co61/Mecanique_Vibratoire/Commande-Acquisition/Tache 2 _ STM32/STM32F411RE.png

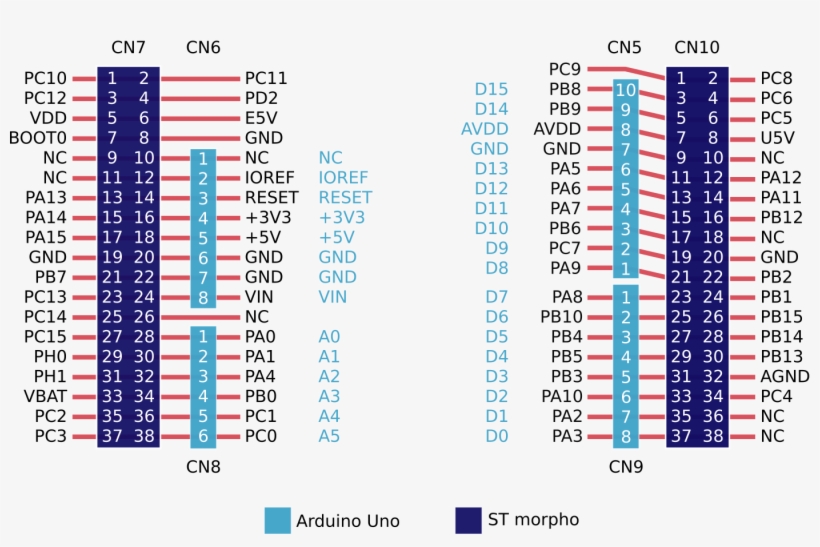
Commande-Acquisition/Tache 2 _ STM32/STM32F411RE.png
