co61/Mecanique_Vibratoire/README.md

# Mecanique_Vibratoire
Conception d'un banc de mesure de flexion sur une lame 
Merci de parcourir les différents dossier pour y découvrir les Rapports asociés
