co61/Mecanique_Vibratoire/Mécanique/Tache 5 _ 6 _ CAO/README.txt

~~~~~~~~~~~~~~~~~~~~~~~~~~~~~ Fichiers Catia : ~~~~~~~~~~~~~~~~~~~~~~~~~~~~

Pour observer la CAO globale : Assemblage "finale.CATProduct"

Dossier "Pupitre sécu V2" : ouvrir "pupitre.CATProduct" et
ensemble "alim.CATProduct".

Dossier "Bloc relais" : contient les fichiers modélisant le relais,
le rail DIN et les blocs de jonction.

Dossier "Electroaimant" : contient les fichiers modélisant l'électroaimant
et son support. La version utilisée dans l'assemblage est la V2.

Dossier "Mise en plan" : contient les .CATDrawing, les pdf, la nomenclature
et le dossier de fabrication

Fichier "lame &fixe.CATProduct" : assemble de la transmission (cadre et
fixation de la lame)

REMARQUE : après tests de fichiers sur plusieurs ordinateurs, certains PC
modifient les noms de fichiers, et l'assemblage ne retrouvent plus les 
fichiers. Tout a été fait pour limiter le risque. Cependant, pour les deux
boutons poussoirs, l'assemblage ne retrouve pas les deux fichiers. Ils se 
situent dans le dossier "pupitre sécu V2" puis les dossiers correspondants
aux boutons.
