co61/Mecanique_Vibratoire/Commande-Acquisition/Tâche 3 _ Intégration élec/composants électroniques/Commande de composants.docx

Liste des composants à commander

Projet CMV - groupe 4

Corentin Esnault

Désignation | code commande RS | Ref fabricant | marque | lien
Bouton-poussoir, Momentané, 2 A, 24 V c.c., Blanc, Montage panneau | 119-2908 | 1212C WHITE | APEM | https://fr.rs-online.com/web/p/boutons-poussoirs/1192908/
électro-aimant linéaire Mecalectro 12 V c.c., course 6mm, force 1N 27 x 22 x 20 mm (modèle poussant, avec ressort de rappel) | 307-3382 | 8.M11 AA 62 12 VCC 100% | Mécalectro | https://fr.rs-online.com/web/p/electroaimants-lineaires/3073382
Cartouche fusible RS PRO, 5A, 5 x 20mm, Type T, 250V c.a. | 563-693 | | RS PRO | https://fr.rs-online.com/web/p/fusibles-cartouches/0563693
Porte-fusible monté sur circuit 10A pour 5 x 20mm, fusible Cartouche 250V c.a. | 176-9047 | 0031.8201 | Schurter | https://fr.rs-online.com/web/p/porte-fusible-pour-ci/1769047

Pourquoi cet électro-aimant :

Dans le cadre de notre projet, afin de contrôler la position du réglet avant l’oscillation libre, nous souhaitons acquérir un électro-aimant solénoïde de type push. L’électro-aimant doit tenir sur la structure et doit avoir une course suffisamment longue pour maintenir le réglet lorsque le piston est sorti tout en restant hors de sa portée lorsque le piston est rentré.

Nous avons choisie l’électro-aimant linéaire Mecalectro 12 V c.c., course 6mm, force 1N 27 x 22 x 20 mm (modèle poussant, avec ressort de rappel)

Code commande RS: 307-3382

Référence fabricant : 8.M11 AA 62 12 VCC 100%

Marque : Mecalectro

En effet, il est alimenté en 12V, la puissance de 30W autorisée par notre système lui est suffisante, ses dimensions (27 x 22 x 20mm) sont peu encombrantes et son châssis permet une fixation simple. Ensuite, sa course de 6mm est suffisante pour bloquer et libérer le réglet. Enfin, il est disponible en poussant (push) et possède un ressort de rappel, ainsi on l’alimente pour le sortir et on coupe l’alimentation pour le rentrer.

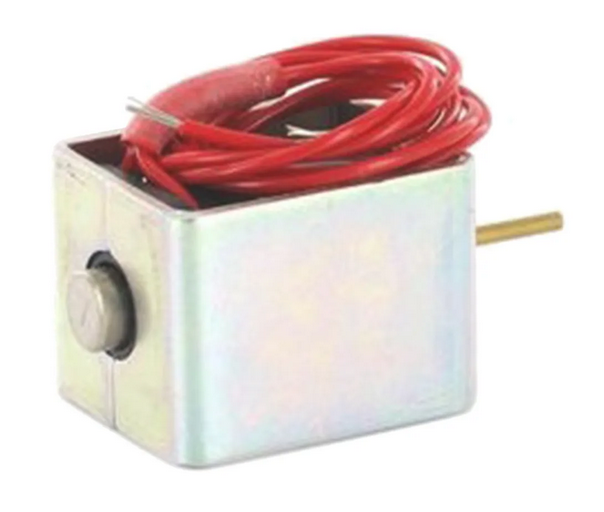
[picture p25: figure]
