co61/Mecanique_Vibratoire/Rapports d_activités PDF/Tache 1 Arduino - Google Docs.pdf

GROUPE N° 4
Tâche N° 1

Intégraon Arduino
Régné 100%

### 1. Etat initial de la tâche :

Au démarrage du semestre nous disposons de codes basiques réalisés l’année dernière. Les codes sont décomposés en deux pares, une pour le capteur accéléromètre, une autre pour la geson de l’asservissement du moteur. Les différents schémas de câblage sont disponibles Les codes devront être très largement améliorés et il sera nécessaire de découvrir une soluon pour rassembler le tout en une seule carte arduino. La vitesse de traitement maximale devra être mesurée.

### 2. Objectifs :

Objecf principal: Réaliser le code Arduino pour répondre aux besoins du projet en ulisant une seule carte Arduino.
- Compréhension et intégraon des codes pour retrouver le fonconnement de l’année précédente
- Amélioraon du code, opmisaon
- Intégraon du code capteur avec le code moteur pour ne garder qu'une carte (100%)
- Geson du port série, dans les deux sens de communicaon (20%)

### 3. Démarche de travail/plannification/problèmes rencontré

Problèmes rencontrés | Soluon supposée / apportée
Code arduino capteur ne correspond pas au capteur possédé, le capteur ulisé ne possède pas de tension de référence les schémas sont donc faux. Le comporte des mulples foncons inules qui ne font qu’alourdir le traitement. | neoyage du code et adaptaon au capteur ulisé cee année pour le groupe 4
Pas de communicaon avancée avec l’IHM pour la mise en place de paramètres spécifiques sur l’arduino, seulement la valeur de l’accéléromètre est transmise. | aente de l’avancement de l’IHM pour connaître les besoins
Code moteur fonconnel mais ne réalisant aucun asservissement, l’asservissement n’est pas fonconnel, la valeur de commande se bloque à la valeur maximale et ne change plus. | recherche de code d’asservissement existant, adaptaon au moteur ulisé, calcul des coefficients d’asservissement.
Deux cartes nécessaire pour le fonconnement actuel | Réflexion sur le nombre de mers et d'interrupons disponible, nombre d’entrée sore suffisantes
Problème de contrôle des Timer pour les différentes tâches | Ulisaon, configuraons à plus bas niveau des 3 mers pour l’ulisaon simultanée de l'accéléromètre et du moteur asservi en vitesse, ainsi que la communicaon temporelle avec le PC

Intégraon Arduino
Régné 100%

### 4. Présentation des résultats obtenus

Les débuts de la tâche d’intégraon du code Arduino ont été le neoyage du code, l’adaptaon du code au capteur ulisé pour l’année 2021 au sein du groupe 4. En effet, celui si ne possède pas de pin Vref et le code effectuait un appel trop complexe et inule de foncons pour une tâche aussi simple que la lecture d’un pin et l’envoie de cee donnée sur le port série. Nous avons dans un premier temps câblé le capteur sur la carte. Grâce aux fils rigides disponibles, la soluon de fils plus fin et sans gaine plasque (fils émaillés) est vite explorée et celui-ci arrivera avec la commande des composants électroniques. Le fil commandé (0.01mm) est beaucoup trop fin pour la réalisaon de soudure simple et correcte ainsi que pour une connuité opmale. Nous conseillons pour les années suivantes d’acheter plus épais tout en restant dans un diamètre qui permet une légèreté et une absence de rigidité : 0.1mm devrait être sasfaisant.
J’effectue ensuite l’affichage des données sous forme de graphiques pour une meilleure interprétaon des données lues. Cet affichage est généré grâce au traceur série délivré par arduino.
Je suis ensuite passé sur la compréhension du code de l’asservissement du moteur. Le code disponible ne possédait pas d’asservissement. Après de nombreuses recherches je me suis donc concentré sur l’ulisaon d’une librairie d’asservissement PID. Cee librairie m’a permis de correctement asservir le moteur, j’ai donc repris le code à parr de zéro.

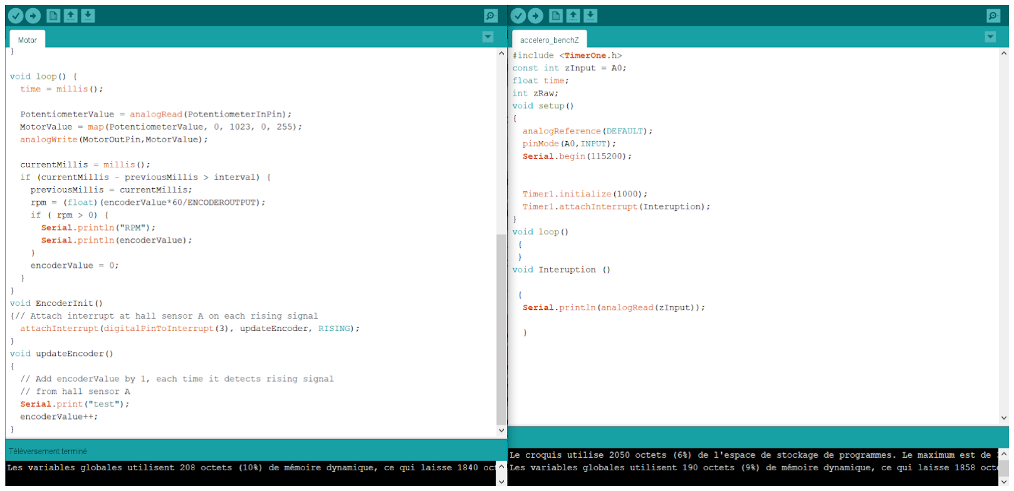
[picture p26: figure]

Figure 1, Code d’origine fourni pour le contrôle moteur et l’acquision de l’accéléromètre Voir le code Code/Moteur_asservi_accelerometre pour le moteur asservi avec l’acquision de l’accéléromètre, le code est commenté.

Intégraon Arduino
Régné 100%
Je me suis ensuite concentré sur la possibilité de réunir tout le code sur une seule carte, car les tests du fonconnement du moteur asservi était très sasfaisant.
Voici le schéma applicable pour l’arduino (à la place de la STM32F411), celui-ci représente toutes les liaisons carte/capteurs nécessaires :

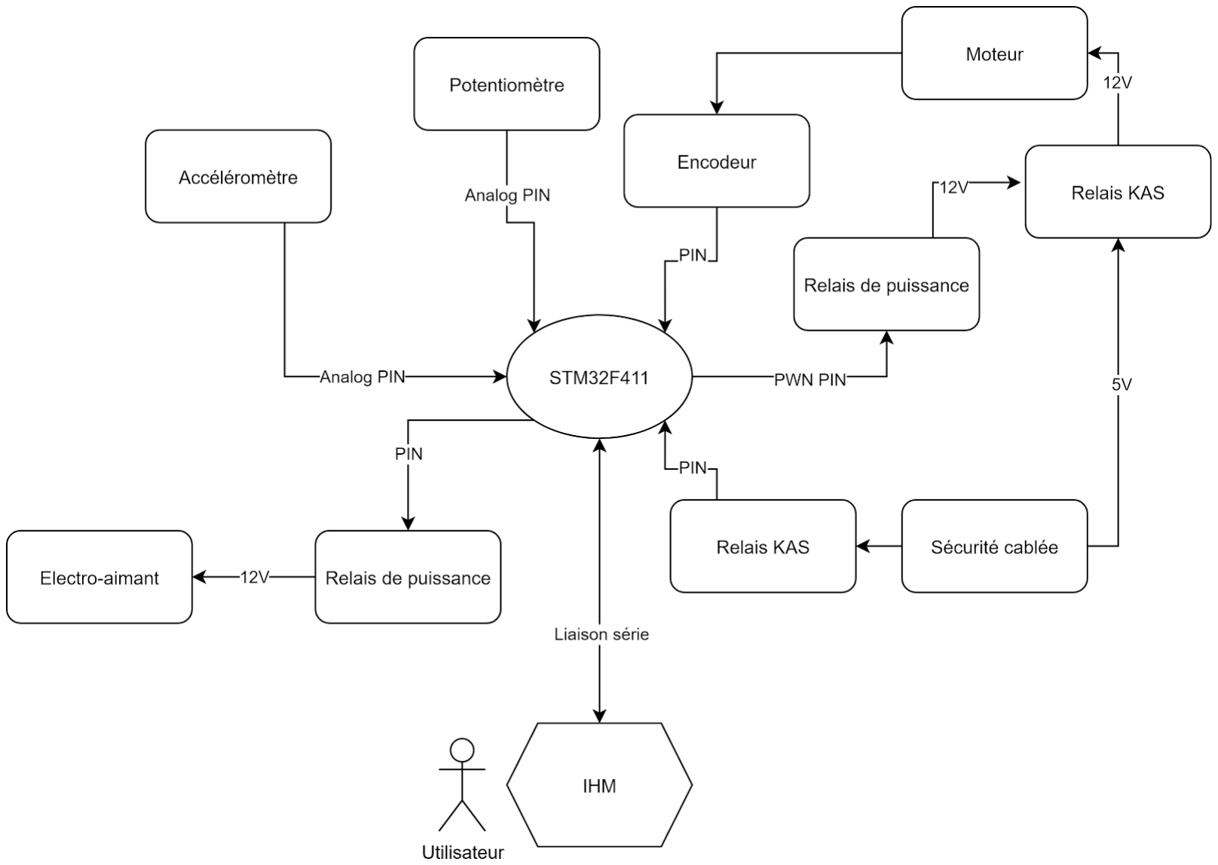
[picture p27: figure]

Figure 2, Schéma représentant les interacons entre les différents composants du système

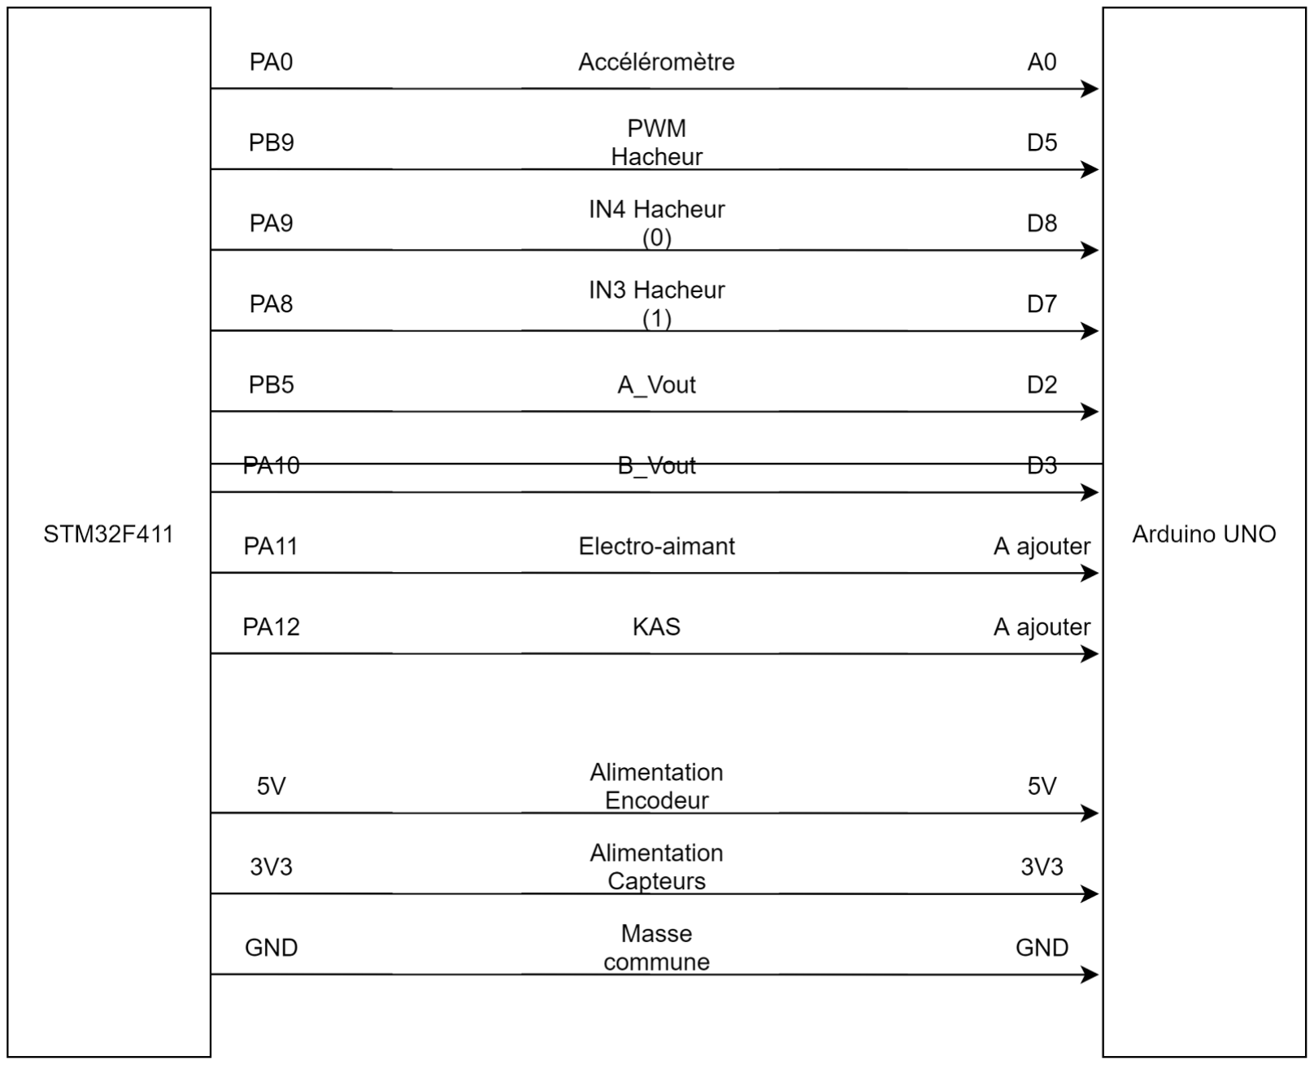
[picture p28: figure]

Figure3, Correspondance des Pin entre STM32 et Arduino, pour le câblage de la carte Arduino sur le PCB à la place de la carte STM32

Intégraon Arduino
Régné 100%
L’ulisaon d’une seule carte nécessite principalement la geson de la lecture et de l’asservissement du moteur en simultané. Il est donc nécessaire de mere en place différents mers en paramétrant leur fréquence d'interrupon pour permere le bon fonconnement de l’asservissement du moteur et de l'échanllonnage des données de l'accéléromètre. Ici j’ai choisi d’asservir le moteur à 10Hz et de lire l’accéléromètre à 1kHz. L'accès simple au mer ne permet pas d’en uliser deux avec des fréquences de fonconnement différentes. J’ai donc dû implémenter les deux mers en écrivant directement dans leur registres comme le montre le code ci-dessous. Nous ulisons donc les mers 1 et 2, en supplément de l’interrupon en entrée de la carte sur le pin 2 sur lequel est branché l’encodeur.


Après cee implémentaon confirmée, le moteur reste bien asservi et les données de l’accéléromètre sont correctement lues. Nous réalisons un horodatage des valeurs pour assurer aucune perte de données du côté du PC et une bonne synchronisaon pour les analyses.
La prochaine amélioraon nécessaire pour rendre l’ulisaon d’arduino complète consiste à établir une transmission correcte du PC vers la carte Arduino pour ainsi permere à l’ulisateur de régler certains paramètres directement via l’IHM. Nos tentaves n’ont pas donné de bons résultats et nous avons dû nous concentrer sur la réalisaon de cee fonconnalité sur STM32.

Intégraon Arduino
Régné 100%

### 5. Bilan des résultats par rapport aux objectifs fixés

Nous avons donc répondu à l’objecf principal qui était de rassembler le code sur une seule carte. L’asservissement fonconne correctement malgré une certaine lenteur à trouver la vitesse de commande. La transmission des valeurs de mesures de l’accéléromètre.
La carte Arduino offre une forte simplicité de codage et des performances plus que sasfaisantes pour les objecfs demandés. Il est de plus possible d’uliser une seule carte Arduino comme présenté précédemment. Contrairement à la STM32 qui offre les mêmes performances, Arduino est simple de prise en main et de nombreux tutoriels ou forum sont très largement disponibles pour réaliser ou comprendre les foncons spéciales nécessaires.

### 6. Perspectives d’évolution

Quant à l’évoluon du code, la transmission séries n’a pas pu être mise en foncon faute
de | temps | pour | le | débuggage. | Il | faudra | donc | connuer | le | code
Code/Moteur_asservi_test_transmission_PC_Carte qui comprend les bases de la récepon séries. (Le code de références reste cependant Code/Moteur_asservi_accelerometre)
Une autre piste d’amélioraon concerne l’amélioraon de la foncon PID, voir son remplacement par une foncon d’asservissement personnel dont la compréhension et les réglages des paramètres seront plus accessibles.
