co61/Mecanique_Vibratoire/Rapports d_activités PDF/Tache 2 STM32 - Google Docs.pdf

GROUPE N° 4
Tâche N° 2

Intégraon STM32F411
Régné 28% Jagline 72%

### 1. Etat initial de la tâche :

(Jagline) Au démarrage du semestre nous ne disposons d’aucun code de base en stm32. La seule source que nous avons est le code Arduino du semestre précédent (ne fonconnant pas vraiment).

### 2. Objectifs :

- Compréhension et intégraon des codes pour comparer le fonconnement à l’arduino
- Amélioraon du code, opmisaon

### 3. Démarche de travail/plannification/problèmes rencontrés

Problèmes rencontrés | Soluon supposée / apportée
Code Arduino ne fonconnant pas | Adaptaon et opmisaon avant de démarrer la Stm32
Pas de code de base | Adaptaon du code Arduino obtenu
Nombreux problèmes avec la DMA, l’ADC | Changement des mers, choix de ne plus uliser le potenomètre
Réalisaon de la PWM | Changement de mer car celui ulisé rentrait en conflit avec les l’ADC

Problème de transmission des données dans le sens PC -> carte

### 4. Présentation des résultats obtenus

Intégraon STM32F411
Régné 28% Jagline 72%
Voici la configuraon des pins:
Accéléromètre | PA0 | ADC1_INO | DMA2_Stream0
IN4 hasheur | PA9 | GPIO_OUTPUT
IN3 hasheur | PA8 | GPIO_OUTPUT
Electro-aimant | PA11 | GPIO_OUTPUT
KAS | PA12 | GPIO_EXTI12
A_Vout | PB6 | TIM4_CH1 | Encoder Mode
B_Vout | PB7 | TIM4_CH2 | Encoder Mode
Timer fonconnement moteur | | TIM5 | 1Hz de base
Timer ADC | | TIM9 | 200Hz
Timer asservissement | | TIM10 | 50Hz
PWM hacheur | PB9 | TIM11_CH1 | PWM Generaon CH1
L’horloge générale de la carte fonconne à 72MHz.

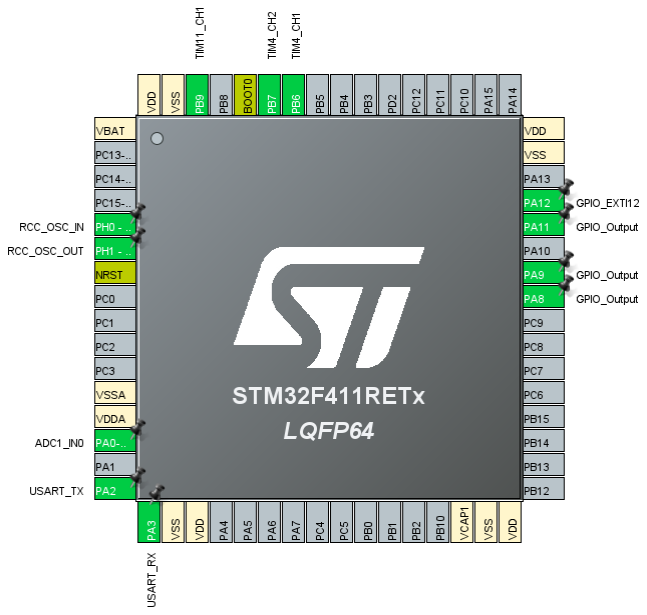
[picture p29: figure]

Figure 1: Pins ulisées sur la STM32F411RE

Intégraon STM32F411
Régné 28% Jagline 72%
Nous avons commencé par tenter de traduire le code Arduino qui était terminé pour que celui-ci fonconne sous STM32. Ceci n’a pas été une bonne idée car nous avons rencontré de trop nombreux problèmes auxquels nous ne nous aendions pas. Leur résoluon à donc été très fasdieuse. Nous avons donc repris chaque foncon une par une en commençant par l’asservissement du moteur. De plus, sous Arduino nous fonconnions avec une librairie externe pour gérer l’asservissement.

Comptage tours moteurs:

Nous avions mis en place une première soluon de comptage de tours moteurs avec une généraon d'interrupons lors d’un front du moteur. Cee soluon fonconnait jusqu’à ce qu’on mee en place l’écoute puis écriture sur le port série selon des commandes, cela faisait beaucoup trop d’interrupons à prendre en compte en boucle en plus de l’écriture et le programme plantait.
Nous avons donc dû changer la méthode de comptage de cks du moteur et avons pour cela ulisé le mode encoder du mer 4. En effet, il n’y a plus d’ interrupons générées constamment, c’est le mer qui prend en charge les cks moteurs reçus par les pins PB6 et PB7. Nous avons alors plus qu’à récupérer sa valeur avec:

Asservissement:

Pour cet asservissement nous avons mis en place un mer pour échanllonner la foncon. Nous avons un mer fonconnant en interrupon à une fréquence de 50Hz. Sa foncon de callback
appelle | donc | notre | foncon | d’asservissement:

Pour calculer les paramètres du mer nous avons effectué le calcul: Preload=(T
out

* F
clk

)/prescaler

Nous avons Fclk=72 000 000Hz, Tout=1/50=0.02s et nous fixons prescaler=72Hz. Soit Auto-reload=19 999 (20 000-1 car nous comptons à parr de 0).

Nous avons ajouté une interrupon sur un pin pour enregistrer les changements d’états de l’encodeur et nous avons finalement ulisé un dernier mer pour générer une PWM qui permet le contrôle en tension du moteur.

Intégraon STM32F411
Régné 28% Jagline 72%
PWM Moteur

Pour commander le moteur nous avons mis en place une généraon de PWM (modulaon de largeur d'impulsion) sur le Timer 11 consistant en générer une succession d’états hauts ou bas permeant de synthéser une valeur moyenne de tension simulant un signal analogique.

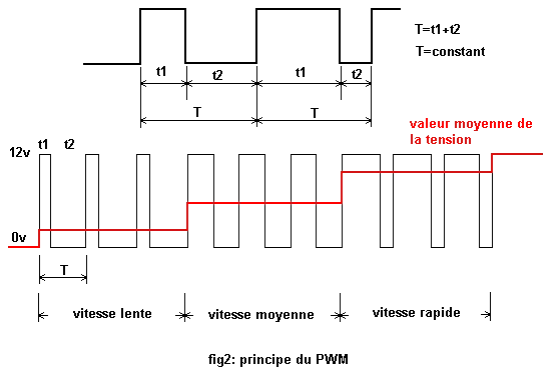
[picture p30: figure]

Figure 2: Principe de la PWM (https://lifesaver.fandom.com/fr/wiki/Modulation_de_Largeur_d%27Impulsion) Cee commande est envoyée au moteur contrôlant sa vitesse par le biais du mer 11.
En effet, nous allons écrire la valeur de commande directement dans le registre de capture/compare du mer ce qui permet de contrôler le rapport cyclique du signal généré.

La généraon de PWM a été assez compliquée à mere en place indirectement car générer une PWM seule fonconnait mais la coupler avec un ADC en lecture de potenomètre ne faisait plus rien fonconner correctement. Ce n’est qu’après de nombreuses heures que nous avons vu que c’était une incompabilité entre l’ADC et les mers ulisés comme nous allons le préciser plus tard pour la lecture de l’accéléromètre.
Nous avons finalement abandonné la lecture d’un potenomètre physique pour laisser son contrôle à l’IHM.

Intégraon STM32F411
Régné 28% Jagline 72%
Lecture des valeurs de l’accéléromètre:

Pour lire les valeurs de l’accéléromètre et pouvoir plus tard les envoyer sur le port série nous avons mis en place un ADC en DMA.
Cela permet de converr une valeur analogique en valeur binaire digital ulisable par la carte. Passer par le mode DMA (Direct Access Memory) (l’ADC peut aussi fonconner en mode Interrupon ou Polling) permet de ne pas passer par le CPU mais d’envoyer les données reçues directement en mémoire, ce qui ne surcharge pas le processeur :

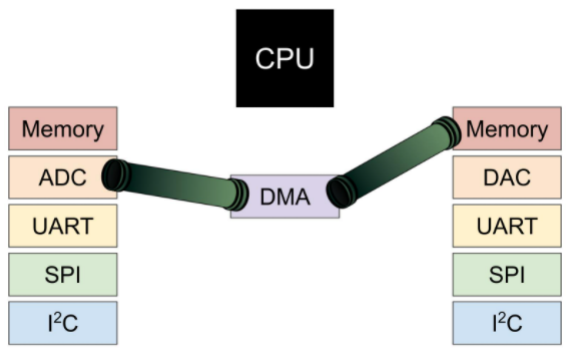
[picture p31: figure]

Figure 3: fonconnement DMA (https://www.digikey.fr/en/maker/projects/getting-started-with-stm32-working-with-adc-and-dma/f5009db3a3ed4370acaf545a3370c30c)

L’ADC décode en boucle les valeurs de l’accéléromètre et les envoie en mémoire directement lorsqu’il termine une conversion en appelant sa callback:

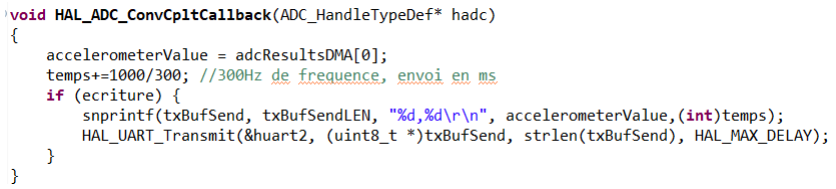
[picture p32: figure]

Nous avons rencontré de nombreux problèmes avec l’ADC DMA et les mers. En effet, il ne fonconnait jamais comme il fallait malgré les très nombreux tutoriels regardés et tests effectués.
Nous avons passé des heures à tenter de comprendre et résoudre les problèmes jusqu’à ce qu’un collègue nous indique avoir eu plusieurs problèmes également avec les mers. Nous avons conclu que les problèmes viennent principalement de conflits entre certains Timer, l’ADC et leurs ulisaons, cependant aucunes informaons de la part du logiciel nous ont été données et cela à rendu la résoluon du problème très complexe.
Et effecvement en changeant nos mers 2, 3 et 3 par les 9, 10 et 11 pour l’ADC, l’asservissement et la PWM moteur, nous avons enfin eu une conversion ADC fonconnelle.

Intégraon STM32F411
Régné 28% Jagline 72%
Nous avons donc pu confirmer la lecture de l’accéléromètre, la transmission des données et son échanllonnage fixe.

La communicaon avec l’IHM:

L’étape finale est de permere de paramétrer le code directement à parr de l’IHM réalisé par Quenn, pour cela nous avons dû mere en place un protocole de communicaon avec un message bien précis qui nous permet de savoir ce que la carte doit recevoir et comment l’analyser. En effet pour pouvoir recevoir le message et l’analyser sur la carte SMT32, nous devions fixer un taille en caractères.

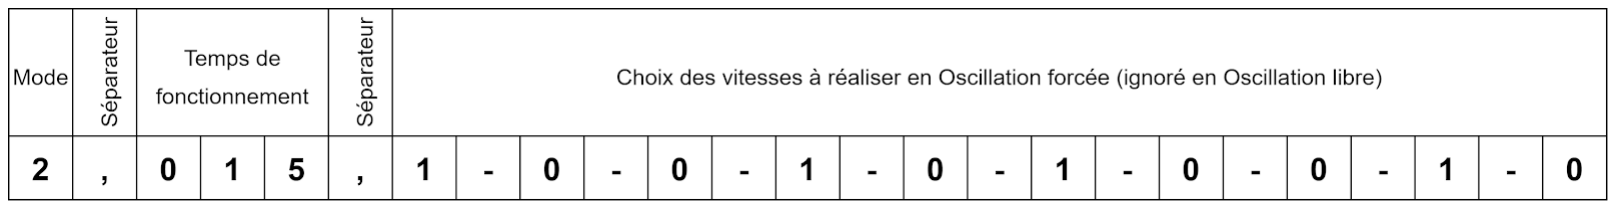
[picture p33: figure]

Figure 4, Représentaon du message série Le message fait donc 25 caractères quel que soit le mode de fonconnement demandé par l’IHM. La carte écoute régulièrement le port série ce qui permet de couper le code ou de changer de mode si l’IHM le demande . Une fois reçu, un foncon (SplitDatas) décompose le message en trois morceaux (repéré grâce aux , ).
Le premier morceau correspond au mode de fonconnement demandé par l’IHM, les valeurs vont de 0 à 3 avec 0 représentant l’alternance d’acvaon de l’électro-aimant, 1 le mode en oscillaon libre, 2 le mode en oscillaon forcée, 3/autre l’arrêt du code.
Le deuxième morceau concerne le temps d’acvaon du moteur suivant pour les différentes vitesses demandées pour le mode 2 en oscillaon forcée.
Le troisième morceau permet au code concernant le mode 2 de déterminer quelles sont les vitesses à réaliser. Les 1 indiquant que cee vitesse doit être générée et les 0 indiquant qu’elle doit être ignorée. Les vitesses sont enregistrées dans un tableau (vitesseBase) dans le code STM32 et ce tableau est mulplié par le tableau de 1 et de 0.

Nous avons mis en place 2 foncons de traitement des données reçues: SplitDatas() et Traitement() qui sont appelées lorsque le port série reçoit une donnée:

Intégraon STM32F411
Régné 28% Jagline 72%


SplitDatas() sert à séparer le message reçu selon les morceaux vus précédemment.
Pour cela la foncon strtok() permet de séparer une chaîne de caractères en plusieurs selon un séparateur, ici “,” pour les 3 blocs principaux mode, temps et vitesses.
Nous refaisons ensuite une séparaon du 3ème bloc vitesses avec “-” pour récupérer chaque consigne de vitesse individuellement et les mere dans un tableau.
Prenons l’exemple précédent, nous nous retrouvons donc avec:
int mode=2;
int tempsMoteur=015;
float vitesse[10] ={1,0,0,1,0,1,0,0,1,0};

Ensuite nous appelons la foncon de traitement des données.

Intégraon STM32F411
Régné 28% Jagline 72%


Traitement analyse le mode reçu et agit en conséquence.
- Si c’est le mode 0, il va acver ou désacver l'électroaimant.
- Si c’est le mode 1 d’oscillaons libres, il va libérer l’électroaimant et envoyer les données de l’accéléromètre en connu.
- Si c’est le mode 2 d’oscillaons forcées, il va récupérer le tempsMoteur et l'envoyer au mer 5 qui génère des interrupons toutes les secondes de base. En les mulpliant on retrouve donc des interrupons selon le temps indiqué dans la trame:

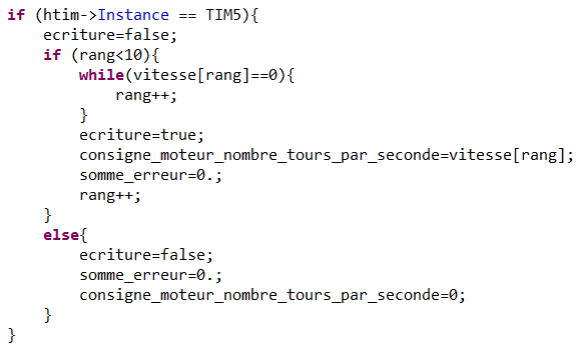
[picture p34: figure]

Lorsqu’une interrupon est générée, on regarde si on est censé tourner le moteur ou non dans le tableau traité précédemment et à quelle vitesse et on envoie les données sur le port série jusqu’à la prochaine interrupon.
- Si c’est un autre chiffre, il va arrêter l’envoi de données et stopper le moteur.

Intégraon STM32F411
Régné 28% Jagline 72%

### 5. Bilan des résultats par rapport aux objectifs fixés

Nous avons donc répondu à l’objecf principal qui était de retrouver le fonconnement Arduino sur la carte STM32F411re.
Cependant, ça n’a pas été simple du tout. Nous avons tout le temps rencontré des problèmes, rien n’a bien fonconné du premier coup. Et nous avons dû passer énormément d’heures à débugger, corriger, trouver d’où ça venait etc.
Que ce soit la PWM qui ne fonconnait que seule, l’ADC qui avait de très nombreux problèmes de compabilité avec les différents mers, tous les mers qu’il a fallu changer, modifier le comptage de tours moteurs qui faisait planter le code, gérer la lecture et l’écriture en connu en faisant aenon que le code ne se bloque pas dans une boucle d’écriture par exemple…
Nous avons malgré tout aeint notre objecf supplémentaire qui était de communiquer des paramètres de l’IHM vers la carte STM pour ainsi contrôler le fonconnement du système grâce à l’IHM, notamment la commande de l’électroaimant et le mode oscillaons forcées permeant de faire tourner le moteur selon les vitesses cochées et le temps choisi sur l’IHM qui fonconnent très bien.

### 6. Perspectives d’évolution

Les évoluons portent principalement sur la résoluon des problèmes de communicaon série entre l’IHM et la carte. Nous avons principalement un problème sur l’écoute régulière du port série.
L’asservissement du moteur peut probablement être amélioré par une déterminaon plus précise des coefficients du PID.
La prise en compte de KAS doit être mise en fonconnement. Une amélioraon des possibilités de contrôle du système via l’IHM peut être envisagée.
