co61/Mecanique_Vibratoire/Vibration/Tache 11 _ Deformées modales/README.txt

~~~~~~~~~~~~~~~~~~~~~~~~~~~~~ Analyse modale : ~~~~~~~~~~~~~~~~~~~~~~~~~~~~

Pour cette tâche, il fallait partir du document x3DDL.AM fourni par Mr. Helbert et l'adapter pour un 
système non pas à 3 éléments à 1 degré de liberté mais n éléments à 2 degrés de liberté.

Malheuresement nous n'avons pas fini cette tâche, nous nous sommes arrêté à l'affichage des courbes 
temporelles.
