co61/Mecanique_Vibratoire/Vibration/Tâche 12 _ Traitement + interprétation des résultats exp/README.txt

~~~~~~~~~~~~~~ Traitements des résultats ~~~~~~~~~~~~

Le fichier .ipynb s'ouvre sur jupyter notebook, il
peut nécessite l'installation de certaines bibliothèques
importées. 
Le fichier .txt d'acquisition est à placer dans le même
dossier.
