co61/Mecanique_Vibratoire/Vibration/Tâche 9 _ 10 _ Superposition modale/README.txt

~~~~~~~~~ Scripts Superposition modale ~~~~~~~~~

Les deux fichiers .ipynb s'ouvrent sur jupyter 
notebook. Veillez à posséder les bibliothèques
importées.
