co61/Mecanique_Vibratoire/Tâche 0 _ gestion de projet/README.docx

Le tableur contient plusieurs feuilles détaillant notamment le volume horaire et la répartition des tâches ainsi que le diagramme de Gantt.

Nous avons décidé de référencer les heures passer et de transformer ça en pourcentage pour ce qui concerne le suivi.
