co61/Mecanique_Vibratoire/Commande-Acquisition/Tache 4 _ IHM/readMe.docx

Version des modules et librairies utilisées pour le code IHM sous Python :

- PyQt5 : 5.15.4
- pyqtgraph : 0.12.2
- pyserial : 3.5
- numpy : 1.20.3
