co61/Mecanique_Vibratoire/Mécanique/Tache 5 _ 6 _ CAO/CAO/Mise en plan/nomenclature_cmv_gr4.pdf

24 | 14 | rondelles plates M3 type N
23 | 2 | rondelles plates M6 type N
22 | 2 | écrous H M6
21 | 12 | écrous H M3 | écrous déjà en notre possession
20 | 4 | vis M3-12 | vis déjà en notre possession
19 | 4 | vis M3-16 | vis déjà en notre possession
18 | 2 | vis M6-12
17 | 14 | vis CS M3-6 | vis déjà en notre possession
16 | 1 | Relais de sécurité | déjà en notre possession
15 | 8 | blocs de jonction
14 | 1 | prise d'alimentation 12V | déjà en notre possession
13 | 1 | porte fusible | déjà en notre possession
12 | 2 | voyant | déjà en notre possession
11 | 1 | Bouton poussoir NF Sa | déjà en notre possession
10 | 1 | Bouton poussoir NO Sm | déjà en notre possession
9 | 1 | Bouton d'arrêt d'urgence | déjà en notre possession
8 | 1 | Rail DIN | rail en notre possession à découper à la dimension | acier
7 | 1 | support électroaimant | | impression 3D
6 | 1 | fixation lame arrière | | aluminium
5 | 1 | fixation lame | | aluminium
4 | 1 | cadre | | aluminium
3 | 4 | panneau d'alimentation 12V | | aluminium
2 | 2 | support cartes électroniques | | aluminium
1 | 4 | support composants pupitre | | aluminium
N° | Nbr | désignation | commentaire | Matière-traitement
Esnault Corentin | CMV 2021A
| quadrinôme N°:4

## BANC TEST VIBRATION

### page 1 /
