co61/Mecanique_Vibratoire/Commande-Acquisition/Tâche 3 _ Intégration élec/composants électroniques/Demande_de_commande.xlsx

Sheet: ENIB 2017
Indiquer le code de commande |  |  |  |  |  |  |  |  |  |  |  |  |  |  |  |  | Renseigner le secteur d'activité | Visa du responsable de service
 | Destination (1) - Code (2) |  |  |  |  |  |  |  | Engagement pluri-annuel |  |  |  | Double code
 | 1) | Sélectionner la destination (menu déroulant) |  |  |  |  | 2) | Puis le code (menu déroulant) "Libellé code - CODE" |  |  |  |  |  |  |  | un code : a = 100%
 | a | D102.FORMATION.INITIALE.ET.CONTINUE |  |  |  |  |  |  |  |  |  |  |  |  |  |  | %
 |  |  |  |  |  | A renseigner uniquement si Double code |  |  |  |  |  |  |  |  |  |  |  | Nom :
 | b |  |  |  |  |  |  |  |  |  |  |  |  |  |  |  | %
AIDE |  | Retrouver un code et une destination à partir de l'ancien service (menus déroulants) |  |  |  |  |  |  |  |  |  |  |  |  |  |  |  | Secteur d'activité |  | Choisir
 |  | 1) Service |  | 2) Code |  |  |  |  |  |  |  | Destination |  |  |  |  |  | pour % prorata de TVA
 |  |  |  |  | Supprimer avant de choisir un nouveau service |  |  |  |  |  |  |  |  |  |  | [début du libellé correspondant]
Fournisseur |  |  | RS Components |  |  |  |  |  |  |  | Téléphone |  | 08 25 03 40 34
 |  |  |  |  |  |  |  |  |  |  | Fax
Désignation |  |  |  |  |  |  |  |  |  | Délais de livraison | N° de réf. |  | Quantités |  | Unité |  |  | Prix unitaire | Montant Total
 |  |  |  |  |  |  |  |  |  |  |  |  | commandées | reçues
Bouton poussoir, momentané, 2A, 24Vcc, Blanc, Montage panneau, REF : 1212C White |  |  |  |  |  |  |  |  |  |  | 119-2908 |  | 4 |  |  |  |  | 4.84 € | 19.36 €
électro-aimant linéaire Mecalectro 12 V c.c., course6mm, force 1N 27 x 22 x 20mm (modèle poussant, avec ressort de rappel) REF : 8.M11 AA 62 12 VCC 100% |  |  |  |  |  |  |  |  |  |  | 307-3382 |  | 4 |  |  |  |  | 34.17 € | 136.68 €
Cartouche fusible RS PRO, 5A, 5x20mm, Type T, 250V c.a. |  |  |  |  |  |  |  |  |  |  | 563-693 |  | 10 |  |  |  |  | 0.31 € | 3.13 €
Porte fusible à montage sur panneau, RS PRO, pour fusible 5x20mm 10 A |  |  |  |  |  |  |  |  |  |  | 188-4630 |  | 4 |  |  |  |  | 3.29 € | 13.16 €
Fil de cuivre 0,007mm² Block 38 AWG Mono conducteur diamètre 0,1mm, longueur 1144m |  |  |  |  |  |  |  |  |  |  | 337-7088 |  | 1 |  |  |  |  | 8.11 € | 8.11 €
Module de relais d'interface 12V c.c., 4 RT, montage Rail DIN, 58 Series |  |  |  |  |  |  |  |  |  |  | 623-7309 |  | 4 |  |  |  |  | 19.83 € | 79.32 €
Prise d'alimentation CC, 5,0A, Montage panneau, 12V 21,3mm |  |  |  |  |  |  |  |  |  |  | 487-832 |  | 4 |  |  |  |  | 6.81 € | 27.24 €
conduit souple flexible, plastique, diamètre nominal 10mm, indice IP55 |  |  |  |  |  |  |  |  |  |  | 429-688 |  | 1 |  |  |  |  | 5.08 € | 5.08 €
 |  |  |  |  |  |  |  |  |  |  |  |  |  |  |  |  |  |  | 0.00 €
 |  |  |  |  |  |  |  |  |  |  |  |  |  |  |  |  |  |  | 0.00 €
 |  |  |  |  |  |  |  |  |  |  |  |  |  |  |  |  |  |  | 0.00 €
Observations : |  |  |  |  |  |  |  |  |  |  |  |  |  |  | TOTAL H.T. |  |  |  | 292.08 €
 |  |  |  |  |  |  |  |  | Demande faite le |  | 2021-10-12 |  |  |  | TVA |  |  | 20.00% | 58.42 €
 |  |  |  |  |  |  |  |  | Nom et signature du demandeur |  |  |  |  |  | TOTAL T.T.C. |  |  |  | 350.50 €
Bon de commande n°
Date de mise à jour du document : 3 mars 2017

Sheet: Feuil1
963
