co61/Mecanique_Vibratoire/Mécanique/Tache 5 _ 6 _ CAO/CAO/Mise en plan/Nomenclature.pdf

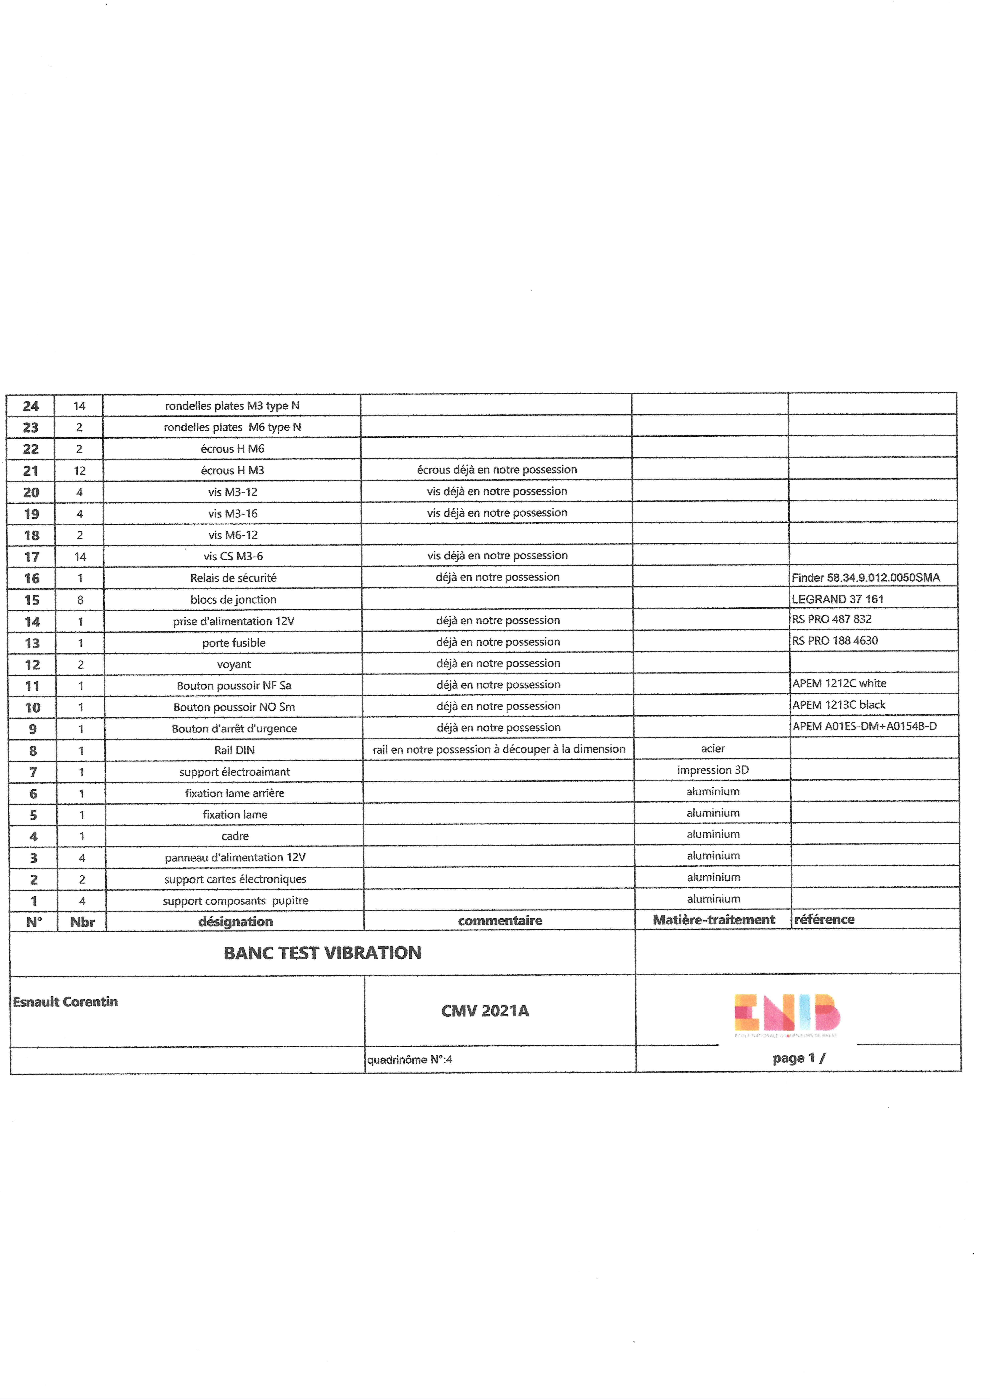
[picture p86: page 1]
