co61/Mecanique_Vibratoire/Mécanique/Tache 5 _ 6 _ CAO/CAO/Mise en plan/Support EA V2 impression 3D.stl

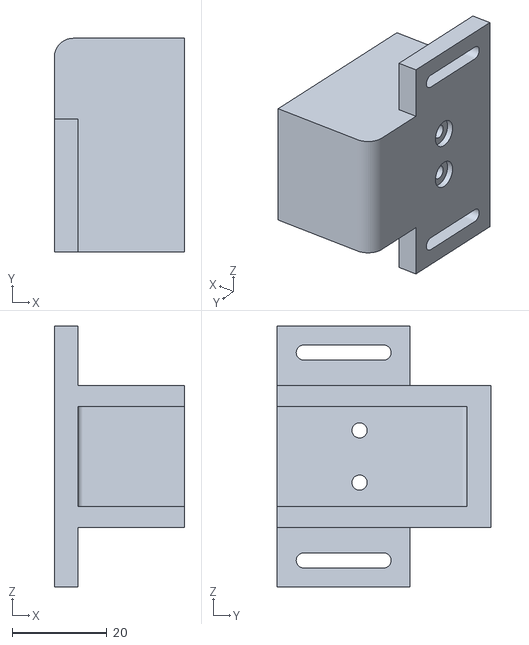
[picture p87: CAD file, 2021-12-14]
Mécanique/Tache 5 _ 6 _ CAO/CAO/Mise en plan/Support EA V2 impression 3D.stl
27.5 x 45.0 x 55.0
