co61/Mecanique_Vibratoire/(list of files, cad)

Other CAD files:
Commande-Acquisition/Tâche 3 _ Intégration élec/Schémas/Fichiers sources/CI_CMV_groupe4.f3z
Mécanique/Tache 5 _ 6 _ CAO/CAO/ASSEMBLAGE 300 200 - Copie.CATProduct
Mécanique/Tache 5 _ 6 _ CAO/CAO/ASSEMBLAGE 300 200.CATProduct
Mécanique/Tache 5 _ 6 _ CAO/CAO/Assemblage ensemble moteur.CATProduct
Mécanique/Tache 5 _ 6 _ CAO/CAO/Assemblage finale.CATProduct
Mécanique/Tache 5 _ 6 _ CAO/CAO/Bloc relais + jonction/Bloc jonction.CATPart
Mécanique/Tache 5 _ 6 _ CAO/CAO/Bloc relais + jonction/Ensemble DIN.CATProduct
Mécanique/Tache 5 _ 6 _ CAO/CAO/Bloc relais + jonction/Rail DIN.CATPart
Mécanique/Tache 5 _ 6 _ CAO/CAO/Bloc relais + jonction/Relais a embase.CATPart
Mécanique/Tache 5 _ 6 _ CAO/CAO/Electroaimant/Electroaimant.CATPart
Mécanique/Tache 5 _ 6 _ CAO/CAO/Electroaimant/Ensemble EA.CATProduct
Mécanique/Tache 5 _ 6 _ CAO/CAO/Electroaimant/Support EA V2.CATPart
Mécanique/Tache 5 _ 6 _ CAO/CAO/Electroaimant/barreau mobile.CATPart
Mécanique/Tache 5 _ 6 _ CAO/CAO/Electroaimant/support EA.CATPart
Mécanique/Tache 5 _ 6 _ CAO/CAO/L298N.CATPart
Mécanique/Tache 5 _ 6 _ CAO/CAO/Lame.CATPart
Mécanique/Tache 5 _ 6 _ CAO/CAO/Moteur2.CATPart
Mécanique/Tache 5 _ 6 _ CAO/CAO/PCB.CATPart
Mécanique/Tache 5 _ 6 _ CAO/CAO/Pupitre sécu V2/120286212-216-1212c_white/1212c_white.CATProduct
Mécanique/Tache 5 _ 6 _ CAO/CAO/Pupitre sécu V2/120286212-216-1212c_white/1212c_white_01.CATPart
Mécanique/Tache 5 _ 6 _ CAO/CAO/Pupitre sécu V2/120286212-216-1212c_white/1212c_white_02.CATPart
Mécanique/Tache 5 _ 6 _ CAO/CAO/Pupitre sécu V2/120286212-216-1212c_white/1212c_white_03.CATPart
Mécanique/Tache 5 _ 6 _ CAO/CAO/Pupitre sécu V2/120286212-216-1212c_white/1212c_white_04.CATPart
Mécanique/Tache 5 _ 6 _ CAO/CAO/Pupitre sécu V2/120286212-216-1212c_white/1212c_white_05.CATPart
Mécanique/Tache 5 _ 6 _ CAO/CAO/Pupitre sécu V2/120286234-216-1213c_black/1213c_black.CATProduct
Mécanique/Tache 5 _ 6 _ CAO/CAO/Pupitre sécu V2/120286234-216-1213c_black/1213c_black_01.CATPart
Mécanique/Tache 5 _ 6 _ CAO/CAO/Pupitre sécu V2/120286234-216-1213c_black/1213c_black_02.CATPart
Mécanique/Tache 5 _ 6 _ CAO/CAO/Pupitre sécu V2/120286234-216-1213c_black/1213c_black_03.CATPart
Mécanique/Tache 5 _ 6 _ CAO/CAO/Pupitre sécu V2/120286234-216-1213c_black/1213c_black_04.CATPart
Mécanique/Tache 5 _ 6 _ CAO/CAO/Pupitre sécu V2/120286234-216-1213c_black/1213c_black_05.CATPart
Mécanique/Tache 5 _ 6 _ CAO/CAO/Pupitre sécu V2/ARU.CATPart
Mécanique/Tache 5 _ 6 _ CAO/CAO/Pupitre sécu V2/Bloc jonction.CATPart
Mécanique/Tache 5 _ 6 _ CAO/CAO/Pupitre sécu V2/Porte fusible.CATPart
Mécanique/Tache 5 _ 6 _ CAO/CAO/Pupitre sécu V2/Pupitre.CATProduct
Mécanique/Tache 5 _ 6 _ CAO/CAO/Pupitre sécu V2/Rail DIN.CATPart
Mécanique/Tache 5 _ 6 _ CAO/CAO/Pupitre sécu V2/Relais a embase.CATPart
Mécanique/Tache 5 _ 6 _ CAO/CAO/Pupitre sécu V2/Support composants.CATPart
Mécanique/Tache 5 _ 6 _ CAO/CAO/Pupitre sécu V2/ensemble alim.CATProduct
Mécanique/Tache 5 _ 6 _ CAO/CAO/Pupitre sécu V2/panneau alim.CATPart
Mécanique/Tache 5 _ 6 _ CAO/CAO/Pupitre sécu V2/prise alimentation.CATPart
Mécanique/Tache 5 _ 6 _ CAO/CAO/Pupitre sécu V2/voyant.CATPart
Mécanique/Tache 5 _ 6 _ CAO/CAO/Support1.CATPart
Mécanique/Tache 5 _ 6 _ CAO/CAO/SupportMoteur.CATPart
Mécanique/Tache 5 _ 6 _ CAO/CAO/_michaud_chailly_B21-GBMC-09.CATPart
Mécanique/Tache 5 _ 6 _ CAO/CAO/_michaud_chailly_B21-GBMR-09_200_10_10_0_1_0.CATPart
Mécanique/Tache 5 _ 6 _ CAO/CAO/assemblage 1.CATProduct
Mécanique/Tache 5 _ 6 _ CAO/CAO/assemblage Axe_bati.CATProduct
Mécanique/Tache 5 _ 6 _ CAO/CAO/axe.CATPart
Mécanique/Tache 5 _ 6 _ CAO/CAO/cadre alum.CATPart
Mécanique/Tache 5 _ 6 _ CAO/CAO/fix lame.CATPart
Mécanique/Tache 5 _ 6 _ CAO/CAO/fixe 2.CATPart
Mécanique/Tache 5 _ 6 _ CAO/CAO/fixe moteur.CATPart
Mécanique/Tache 5 _ 6 _ CAO/CAO/lame fixe.CATProduct
Mécanique/Tache 5 _ 6 _ CAO/CAO/plaque.CATPart
Mécanique/Tache 5 _ 6 _ CAO/CAO/profil-100mm.CATPart
Mécanique/Tache 5 _ 6 _ CAO/CAO/profil-150mm .CATPart
Mécanique/Tache 5 _ 6 _ CAO/CAO/profil-200mm.CATPart
Mécanique/Tache 5 _ 6 _ CAO/CAO/profil-300mm.CATPart
Mécanique/Tache 5 _ 6 _ CAO/CAO/profil-50mm.CATPart
Mécanique/Tache 5 _ 6 _ CAO/CAO/support cartes.CATPart
