co61/Mecanique_Vibratoire/Mécanique/Tache 5 _ 6 _ CAO/Dossier_fabrication_CMV_gr_4.pdf

4

360.54

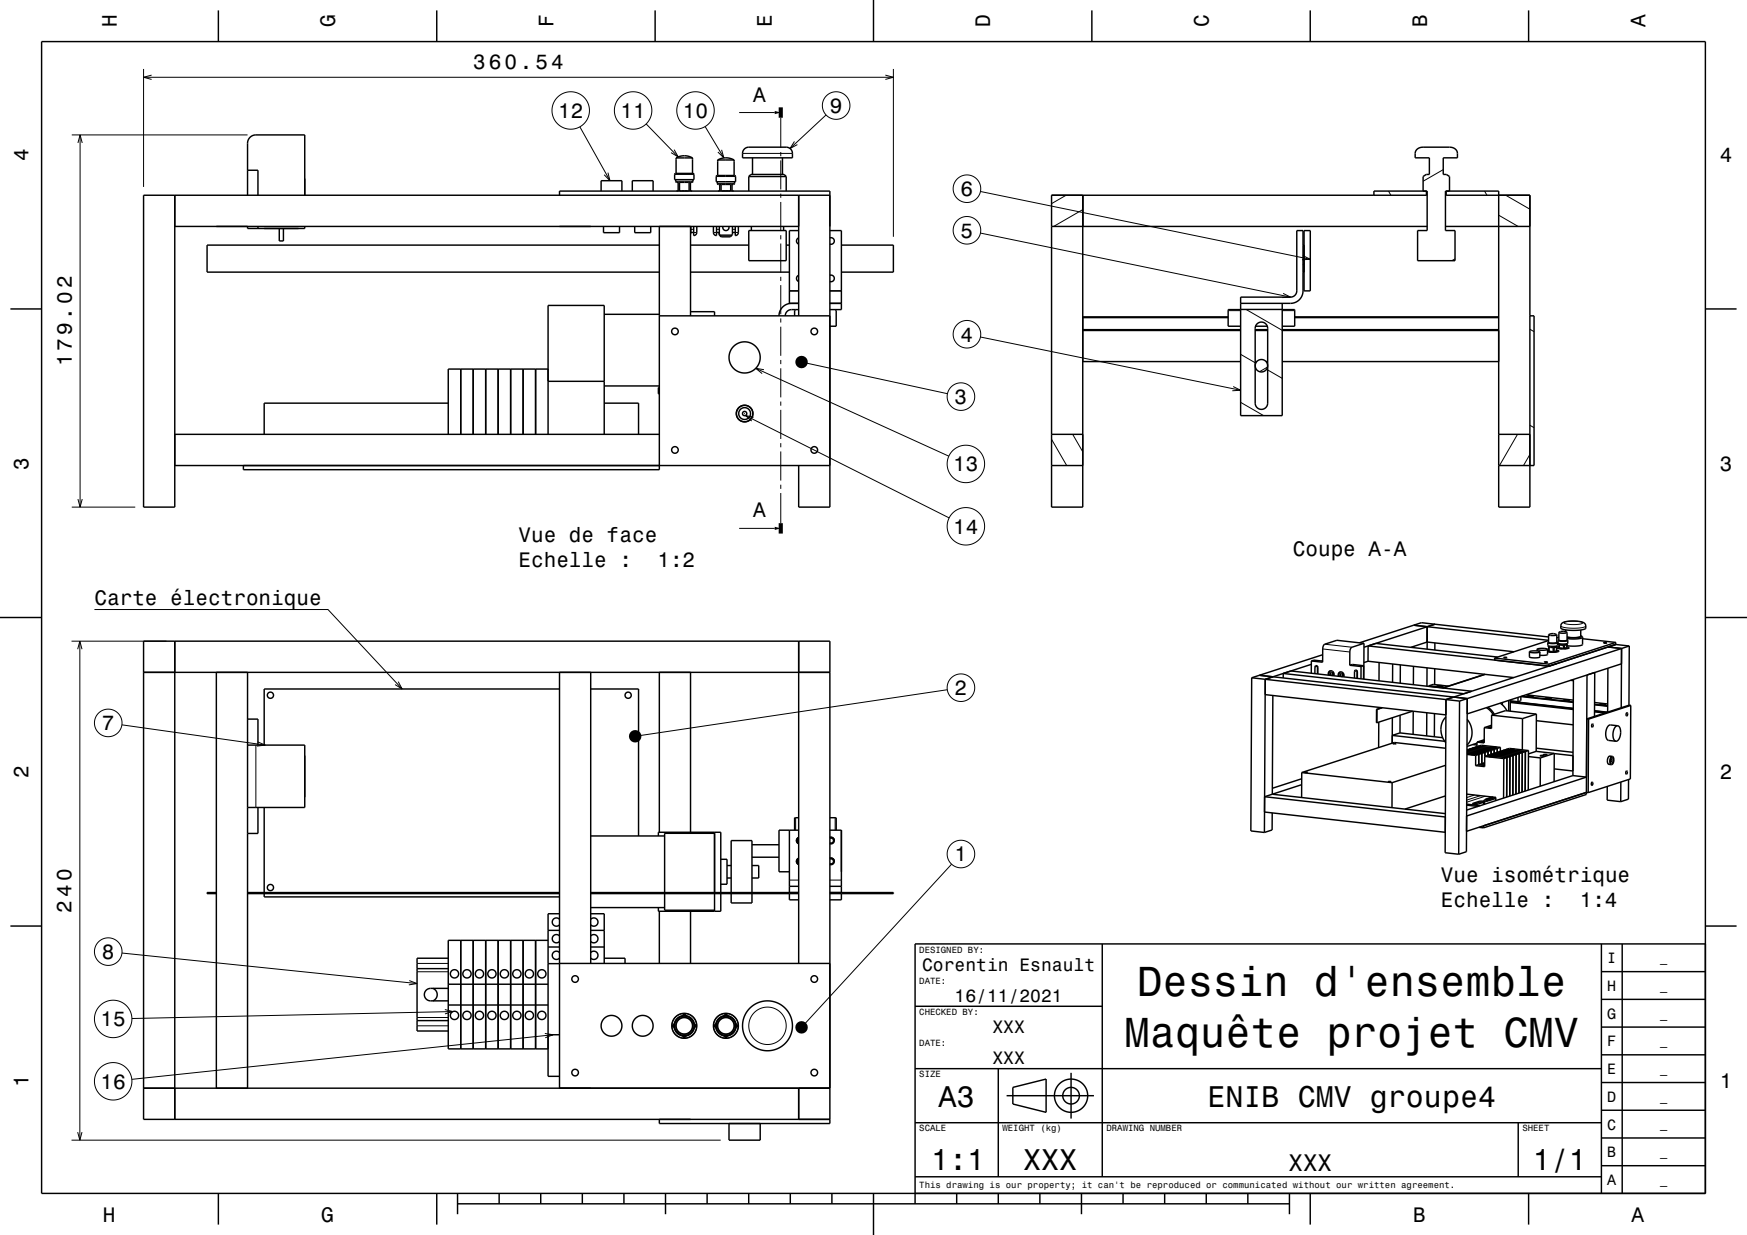
[picture p88: page 1]
CHECKED BY:; XXX; DATE:; Carte électronique; Coupe A-A; Vue isométrique Echelle : 1:4

Vue de face
Echelle : 1:2

DESIGNED BY: Corentin Esnault DATE: 16/11/2021 | Dessin d'ensemble Maquête projet CMV | I | _

SIZE A3 | | | | ENIB CMV groupe4

SCALE | WEIGHT (kg) XXX | DRAWING NUMBER XXX | SHEET

This drawing is our property; it can't be reproduced or communicated without our written agreement.


4

30

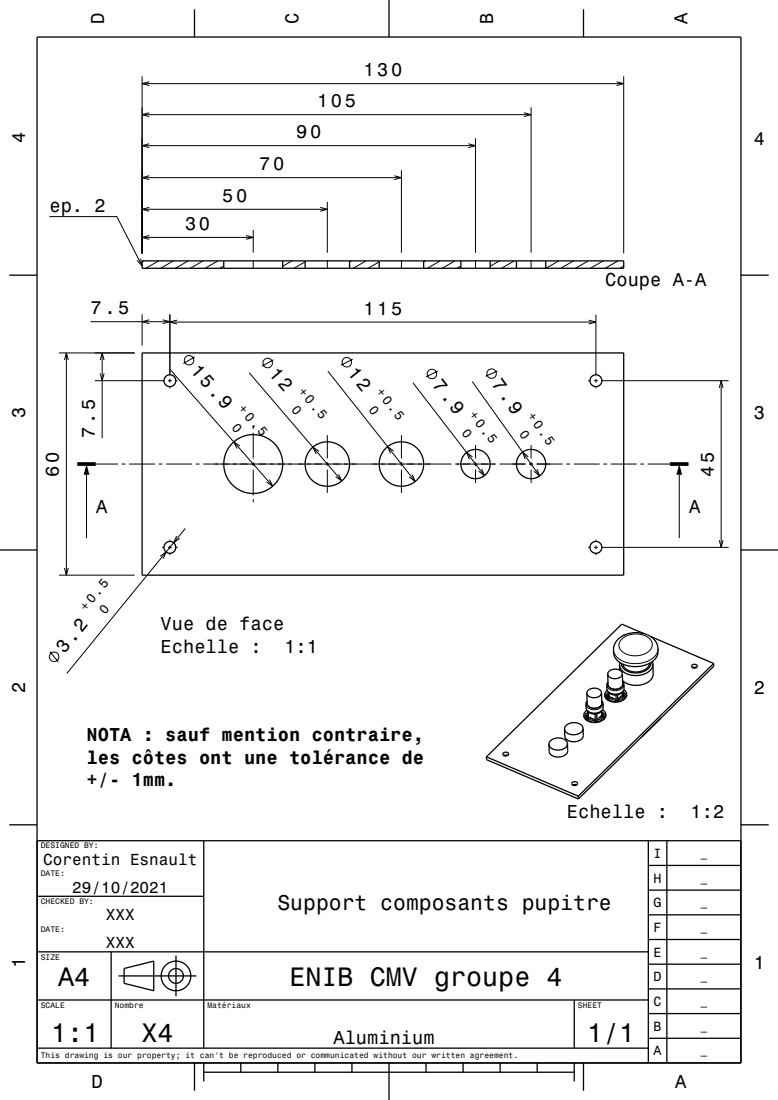
[picture p89: page 3]
CHECKED BY:; XXX; DATE:; Vue de face Echelle : 1:1; Echelle : 1:2; Coupe A-A

NOTA : sauf mention contraire,
les côtes ont une tolérance de

DESIGNED BY: Corentin Esnault DATE: 29/10/2021 | Support composants pupitre | I | _

SIZE A4 | | | | ENIB CMV groupe 4

SCALE | Nombre X4 | Matériaux Aluminium | SHEET

4

7.5 ±0.5

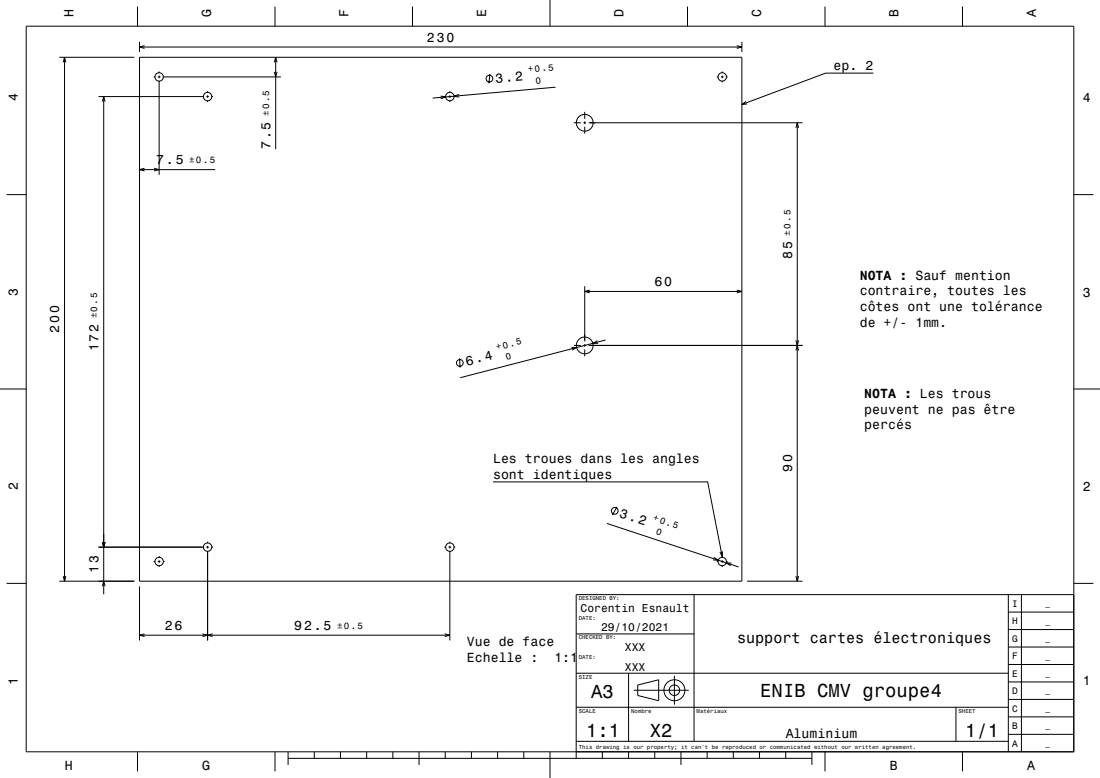
[picture p90: page 4]
CHECKED BY:; XXX; DATE:

NOTA : Sauf mention
contraire, toutes les
côtes ont une tolérance

NOTA : Les trous
peuvent ne pas être
percés

Les troues dans les angles
sont identiques

DESIGNED BY: Corentin Esnault DATE: 29/10/2021 | support cartes électroniques | I | _

Vue de face
Echelle : 1:1

SIZE A3 | | | | ENIB CMV groupe4

SCALE | Nombre | Matériaux | SHEET

4

12.7 +0.5

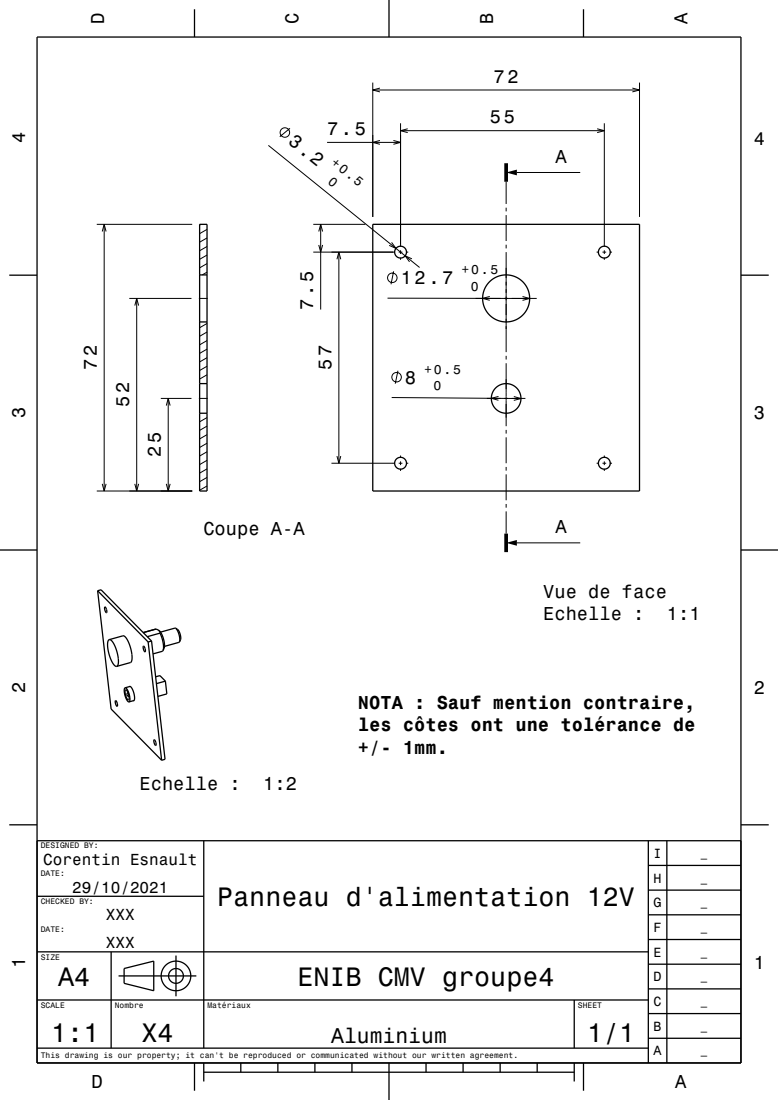
[picture p91: page 5]
CHECKED BY:; XXX; DATE:; Echelle : 1:2 ²⁵; Coupe A-A

Vue de face
Echelle : 1:1

NOTA : Sauf mention contraire,
les côtes ont une tolérance de

DESIGNED BY: Corentin Esnault DATE: 29/10/2021 | Panneau d'alimentation 12V | I | _

SIZE A4 | | | | ENIB CMV groupe4

SCALE | Nombre | Matériaux | SHEET

4

10 ±0.5

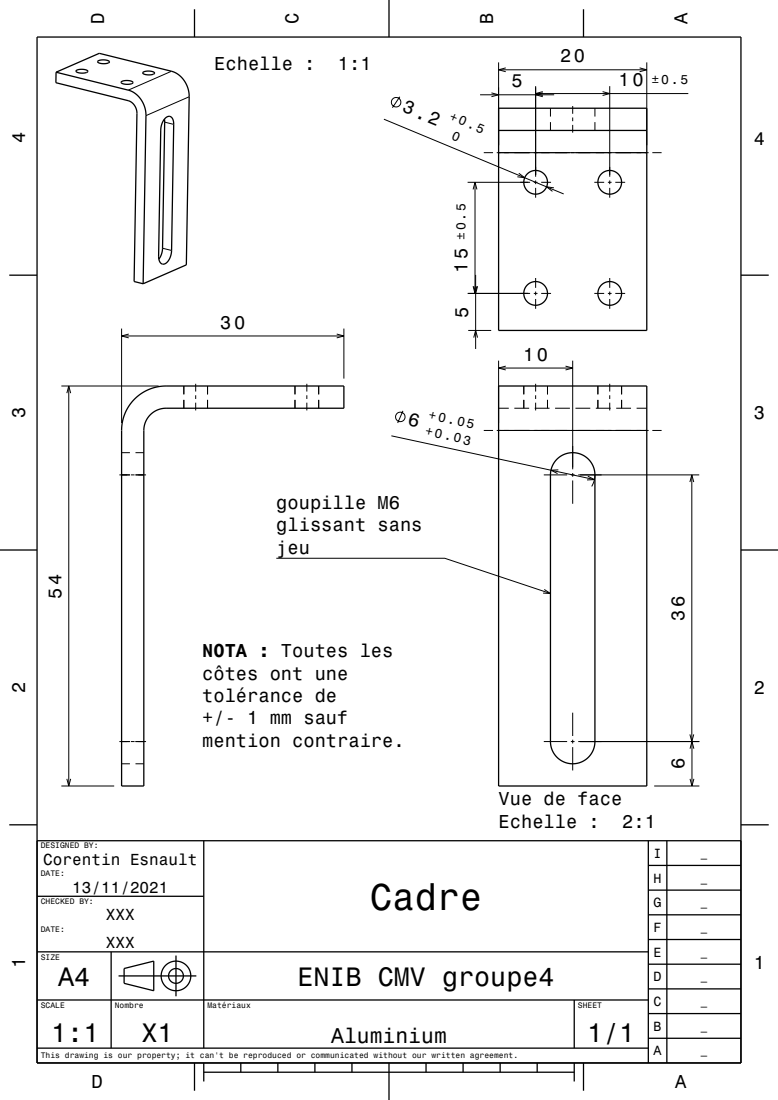
[picture p92: page 6]
CHECKED BY:; XXX; DATE:; goupille M6 glissant sans jeu; Echelle : 1:1

NOTA : Toutes les
côtes ont une
tolérance de
+/- 1 mm sauf
mention contraire.

Vue de face
Echelle : 2:1

DESIGNED BY: Corentin Esnault DATE: 13/11/2021 | Cadre | I | _

SIZE A4 | | | | ENIB CMV groupe4

SCALE | Nombre | Matériaux | SHEET

4

# X1³⁵

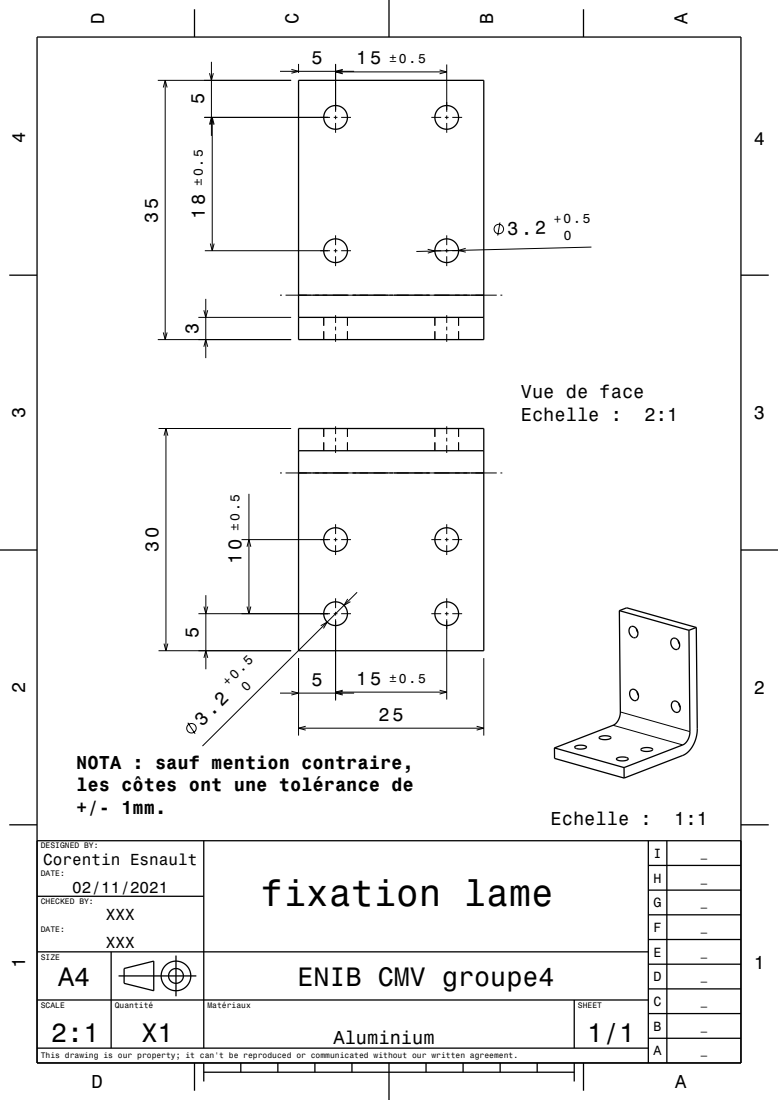
[picture p93: page 7]
CHECKED BY:; XXX; DATE:; Echelle : 1:1

Vue de face
Echelle : 2:1

NOTA : sauf mention contraire,
les côtes ont une tolérance de

DESIGNED BY: Corentin Esnault DATE: 02/11/2021 | fixation lame | I | _

SIZE A4 | | | | ENIB CMV groupe4

SCALE | Quantité | Matériaux | SHEET

4

15 ±0.5

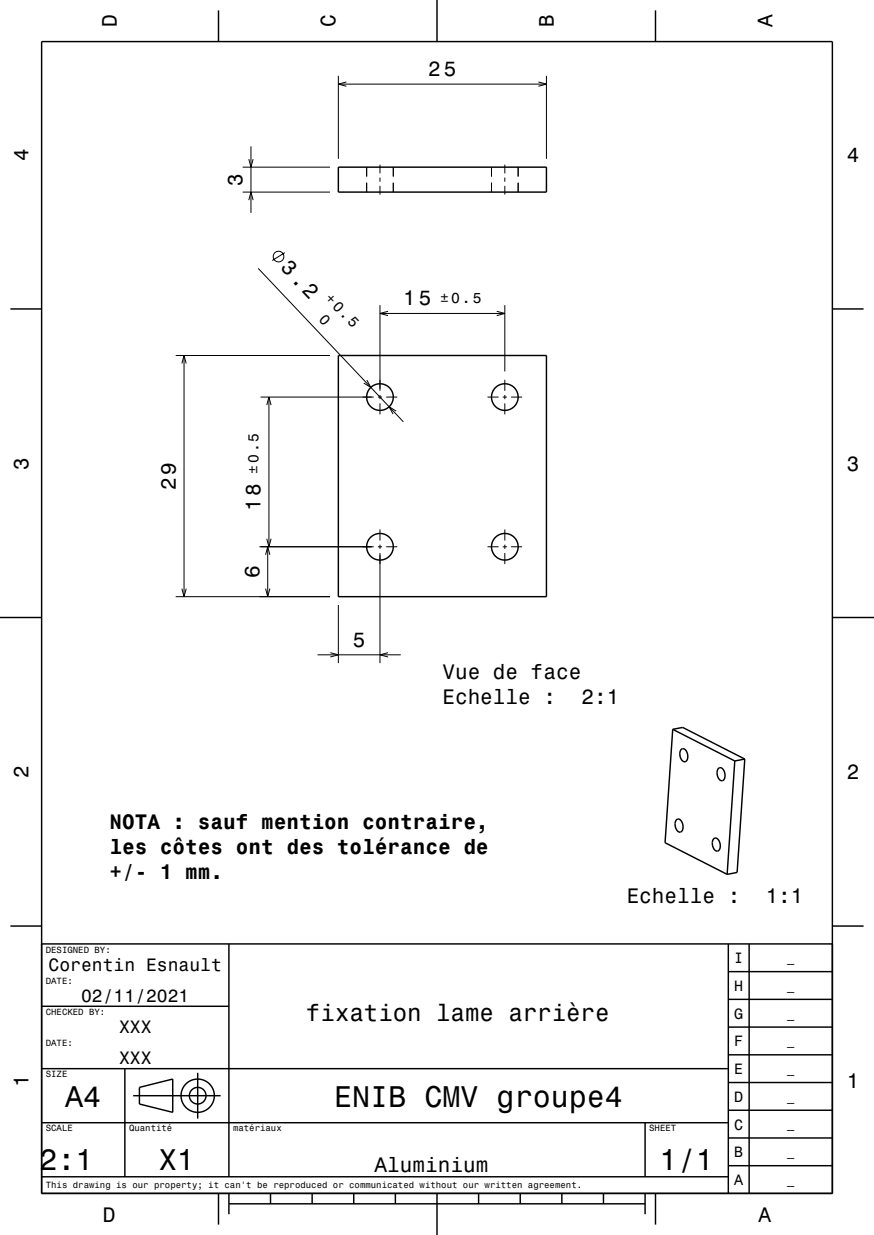
[picture p94: page 8]
CHECKED BY:; XXX; DATE:; Echelle : 1:1

Vue de face
Echelle : 2:1

NOTA : sauf mention contraire,
les côtes ont des tolérance de

DESIGNED BY: Corentin Esnault DATE: 02/11/2021 | fixation lame arrière | I | _

SIZE A4 | | | | ENIB CMV groupe4

SCALE | Quantité | matériaux | SHEET

## NOTA : Les différences mises en commentaire

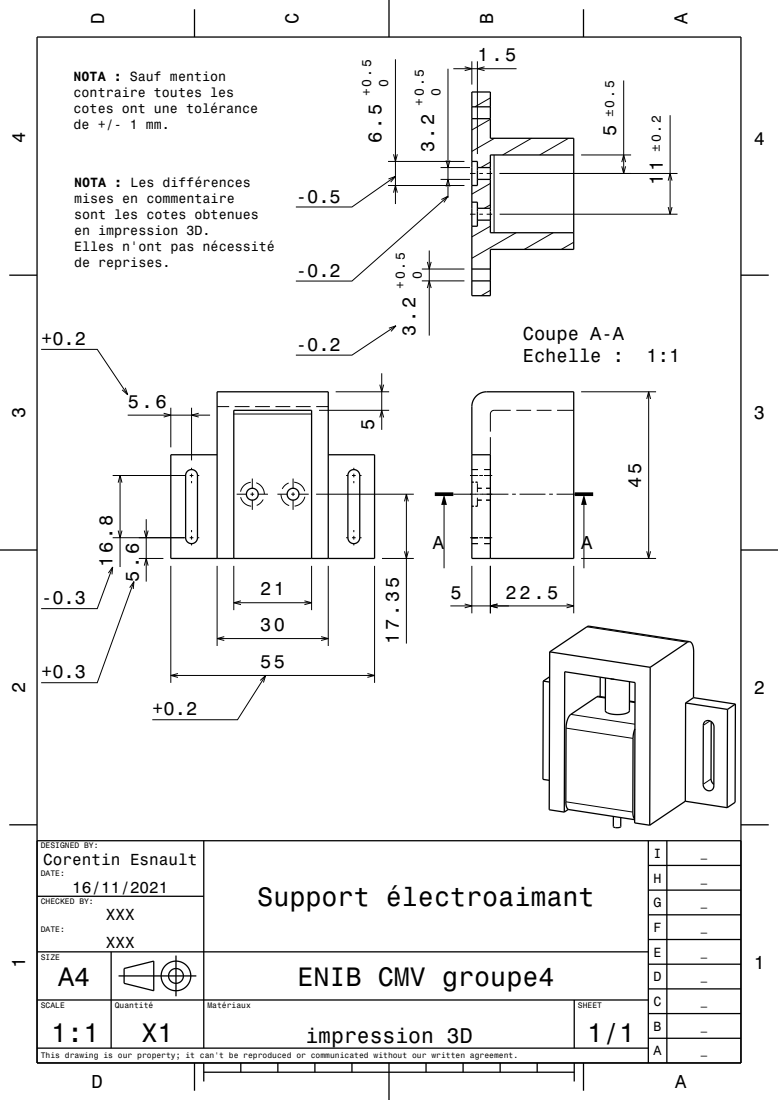
[picture p95: page 9]
CHECKED BY:; XXX; DATE:; Coupe A-A Echelle : 1:1

NOTA : Sauf mention
contraire toutes les
cotes ont une tolérance

sont les cotes obtenues
en impression 3D.
Elles n'ont pas nécessité
de reprises.

DESIGNED BY: Corentin Esnault DATE: 16/11/2021 | Support électroaimant | I | _

SIZE A4 | | | | ENIB CMV groupe4

SCALE | Quantité | Matériaux impression 3D | SHEET

4
100

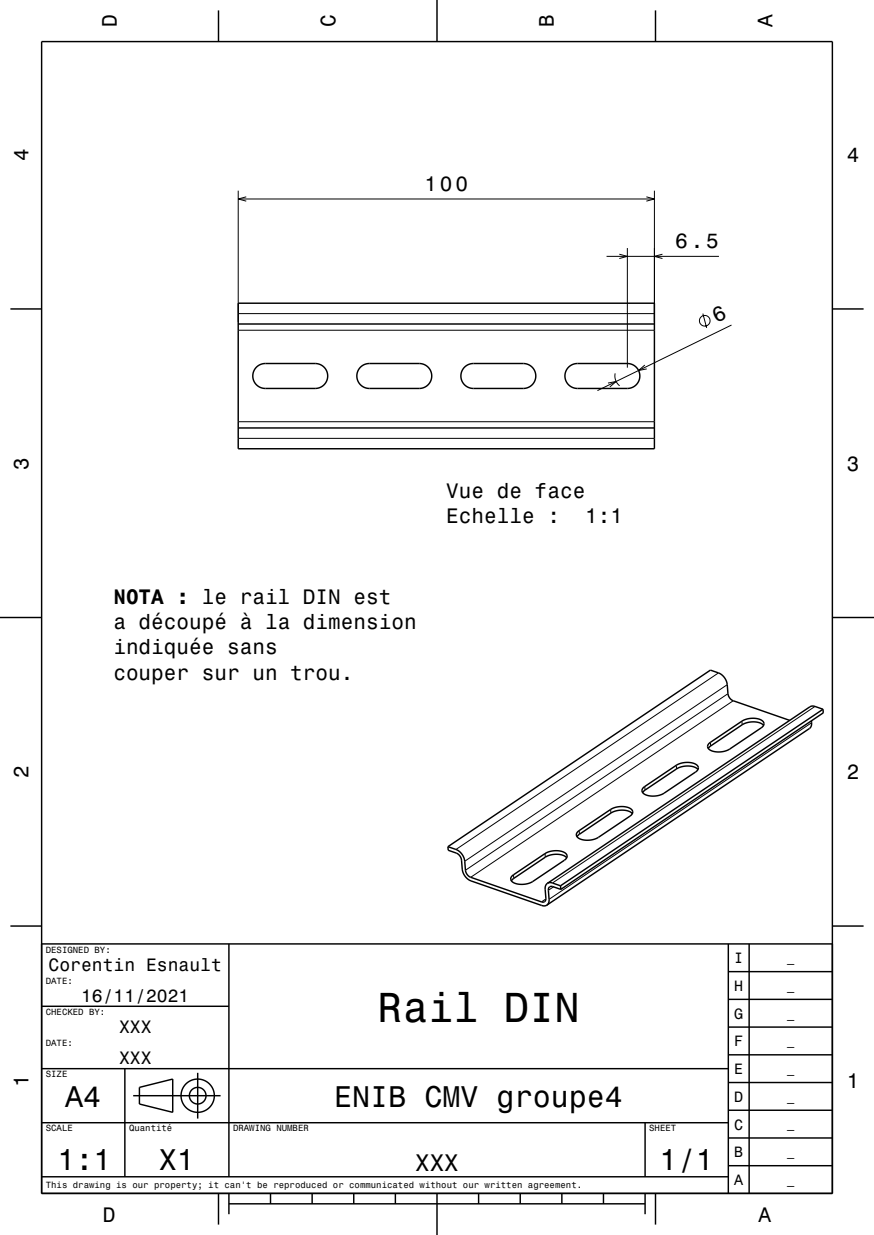
[picture p96: page 10]
CHECKED BY:; XXX; DATE:

Vue de face
Echelle : 1:1

NOTA : le rail DIN est
a découpé à la dimension
indiquée sans
couper sur un trou.

DESIGNED BY: Corentin Esnault DATE: 16/11/2021 | Rail DIN | I | _

SIZE A4 | | | | ENIB CMV groupe4

SCALE | Quantité | DRAWING NUMBER XXX | SHEET
