co61/Mecanique_Vibratoire/Commande-Acquisition/Tâche 3 _ Intégration élec/Schémas/schéma_sécu_cablé_et_puissance.pdf

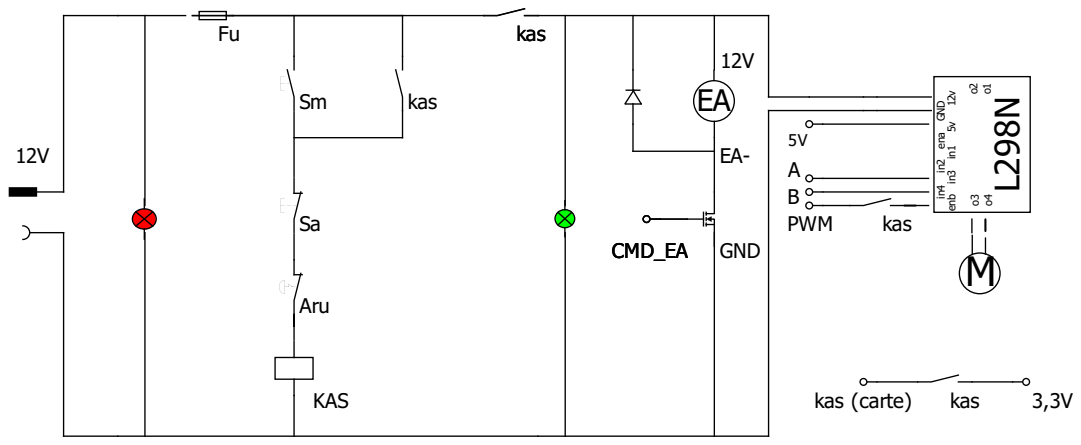
[picture p97: page 1]
CMD_EA; in1 5v 12v GND; enb; ena; B PWM; Aru; KAS; GND; kas; kas (carte)

Auteur : Corentin Esnault | Schéma de puissance électrique avec sécurité | Fichier :
Date : 13/11/2021 | | Folio : 1/1
