co61/Mecanique_Vibratoire/Mécanique/Tache 5 _ 6 _ CAO/CAO/Mise en plan/railDIN.pdf

CHECKED BY:

Vue de face
Echelle : 1:1

NOTA : le rail DIN est
a découpé à la dimension
indiquée sans
couper sur un trou.

DESIGNED BY: Corentin Esnault DATE: 16/11/2021 | Rail DIN | I | _

SIZE A4 | | | | ENIB CMV groupe4

SCALE 1:1 | Quantité X1 | DRAWING NUMBER XXX | SHEET 1/1

This drawing is our property; it can't be reproduced or communicated without our written agreement.
