co61/Mecanique_Vibratoire/Mécanique/Tache 5 _ 6 _ CAO/CAO/Mise en plan/support EA.pdf

CHECKED BY:; Coupe A-A Echelle : 1:1

NOTA : Sauf mention
contraire toutes les
cotes ont une tolérance

NOTA : Les différences
mises en commentaire
sont les cotes obtenues
en impression 3D.
Elles n'ont pas nécessité
de reprises.

DESIGNED BY: Corentin Esnault DATE: 16/11/2021 | Support électroaimant | I | _

SIZE A4 | | | | ENIB CMV groupe4

SCALE 1:1 | Quantité X1 | Matériaux impression 3D | SHEET 1/1

This drawing is our property; it can't be reproduced or communicated without our written agreement.
