co61/Mecanique_Vibratoire/Commande-Acquisition/Tâche 3 _ Intégration élec/Schémas/Fichiers sources/board_CI.brd

## EAGLE design Commande-Acquisition/Tâche 3 _ Intégration élec/Schémas/Fichiers sources/board_CI.brd (2021-12-14)

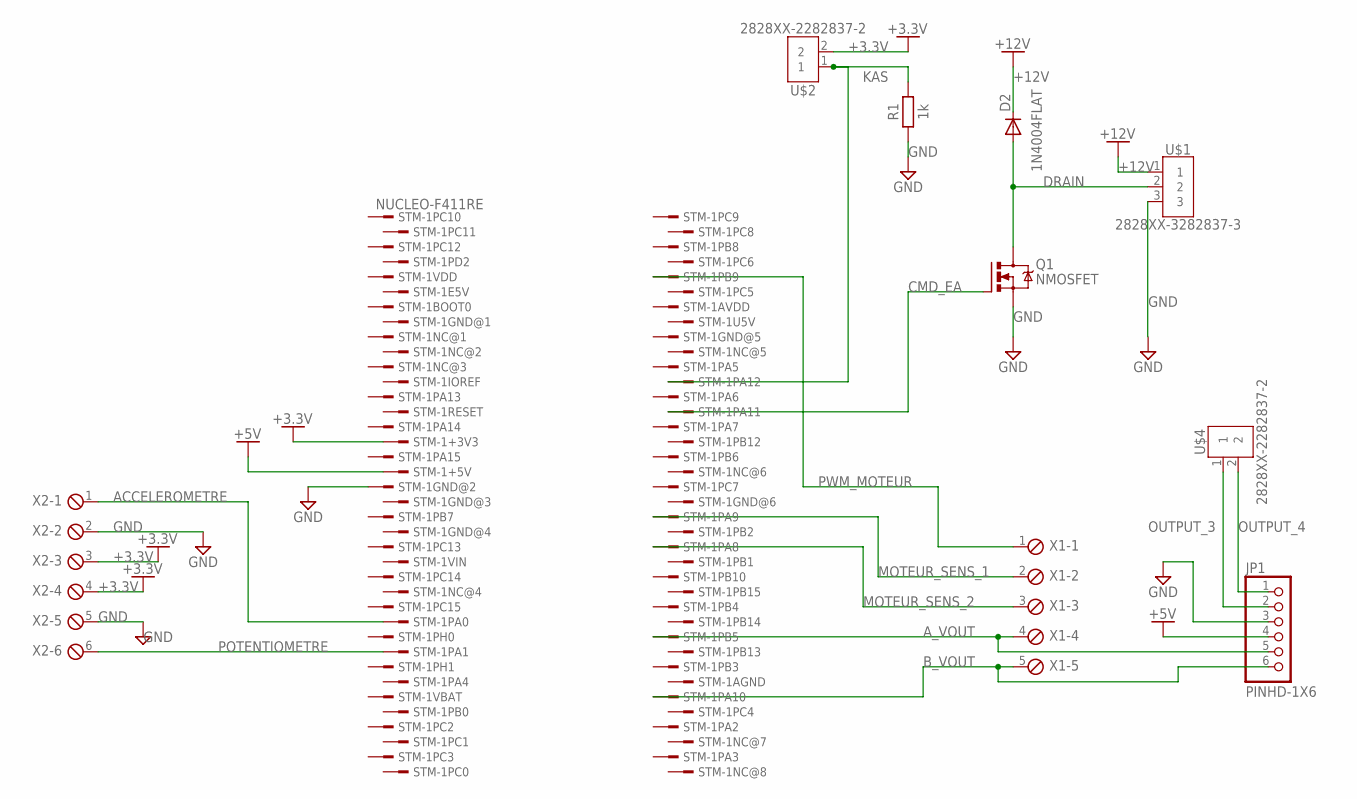
[picture p98: schematic Schéma_CI.sch]

Parts:
D2: 1N4004FLAT; DO41-10
JP1: PINHD-1X6; 1X06
Q1: NMOSFET; TO220BV
R1: 1k; RESAD724W46L381D178B
STM-1: NUCLEO-F411RE; CONN_STM32_NUCLEO
U$1: 2828XX-3282837-3; TERMBLK_508-3N
U$2, U$4: 2828XX-2282837-2; TERMBLK_508-2N
X1: MPT5; 5POL254
X2: MPT6; 6POL254

Connections:
+3.3V: STM-1.16, U$2.2, X2.3, X2.4
+5V: JP1.4, STM-1.18
+12V: D2.C, U$1.1
ACCELEROMETRE: STM-1.28, X2.1
A_VOUT: JP1.5, STM-1.67, X1.4
B_VOUT: JP1.6, STM-1.71, X1.5
CMD_EA: Q1.G, STM-1.52
DRAIN: D2.A, Q1.D, U$1.2
GND: JP1.3, Q1.S, R1.1, STM-1.19, U$1.3, X2.2, X2.5
KAS: R1.2, STM-1.50, U$2.1
MOTEUR_SENS_1: STM-1.59, X1.2
MOTEUR_SENS_2: STM-1.61, X1.3
OUTPUT_3: JP1.2, U$4.1
OUTPUT_4: JP1.1, U$4.2
POTENTIOMETRE: STM-1.30, X2.6
PWM_MOTEUR: STM-1.43, X1.1

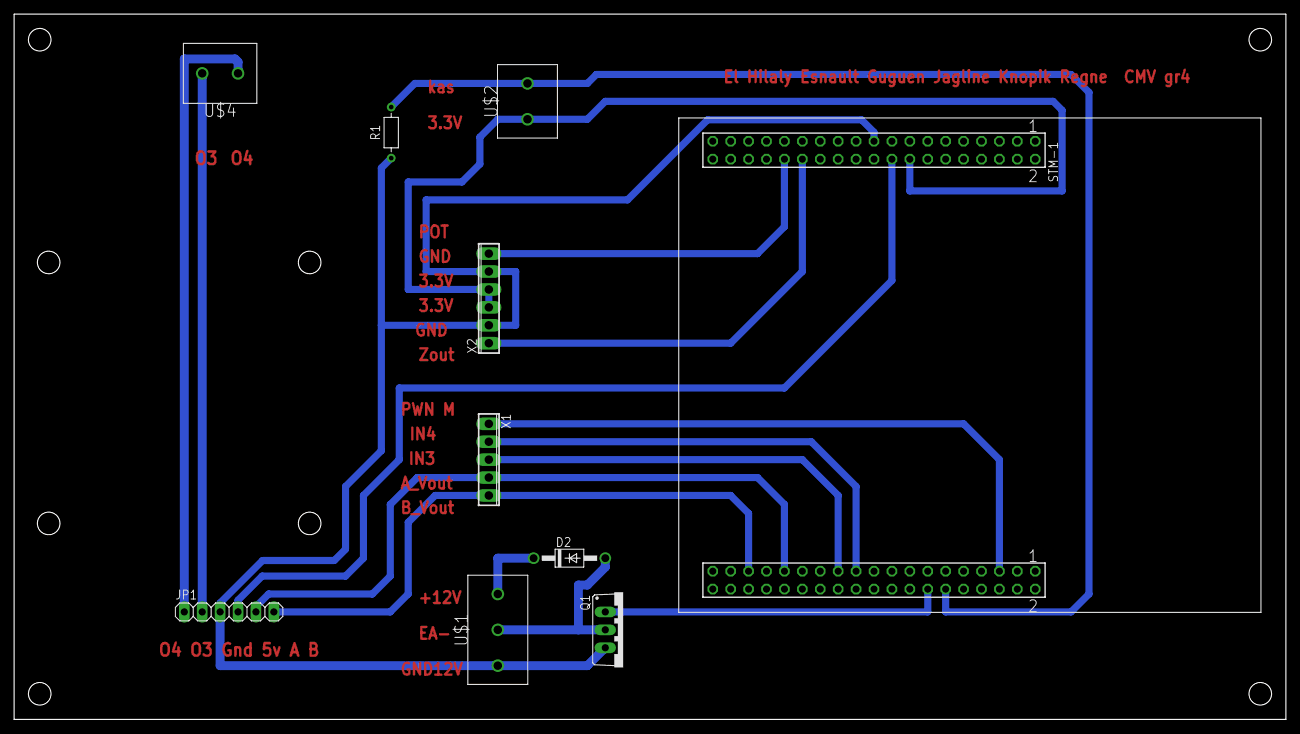
[picture p99: board board_CI.brd from above]

Board: 2 copper layers, 180.3 x 100.0 mm, 10 parts (0 on the bottom side), 16 nets.
